unl-rpg/Unify/Hardware/Unify_1/Documentation/Igniters/MJG_Firewire_Initiator.png

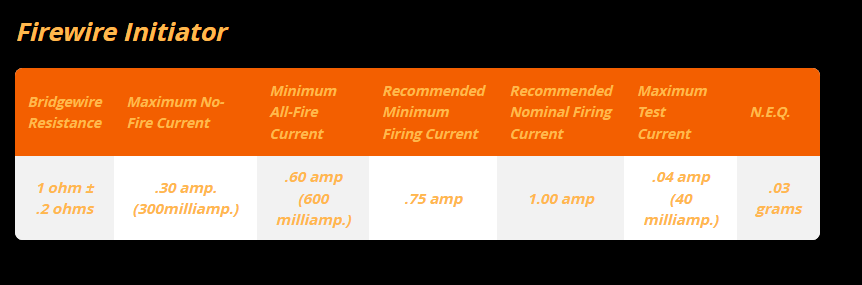
Hardware/Unify_1/Documentation/Igniters/MJG_Firewire_Initiator.png
