unl-rpg/Unify/Hardware/Unify_1/Documentation/Simulations/CapacitanceMultiplier5V.png

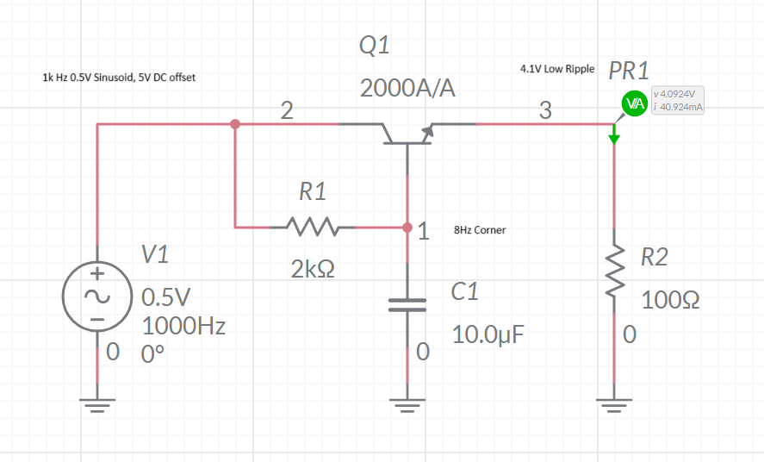
Hardware/Unify_1/Documentation/Simulations/CapacitanceMultiplier5V.png
