unl-rpg/Unify/Hardware/Unify_1/Documentation/Simulations/LinearIgniter.png

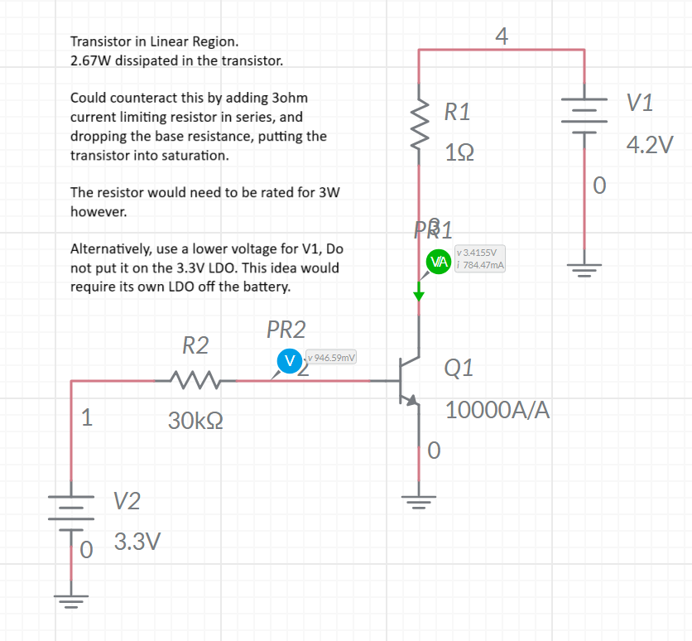
Hardware/Unify_1/Documentation/Simulations/LinearIgniter.png
