unl-rpg/Unify/Hardware/Unify_1/Documentation/Simulations/SaturationLevelShiftingInverter.png

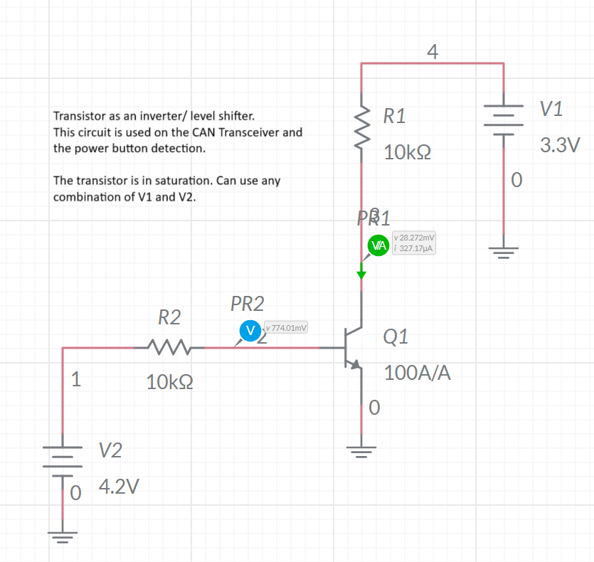
Hardware/Unify_1/Documentation/Simulations/SaturationLevelShiftingInverter.png
