unl-rpg/Unify/Hardware/Unify_1/Orders/JLCPCB_3-16-2025.pdf

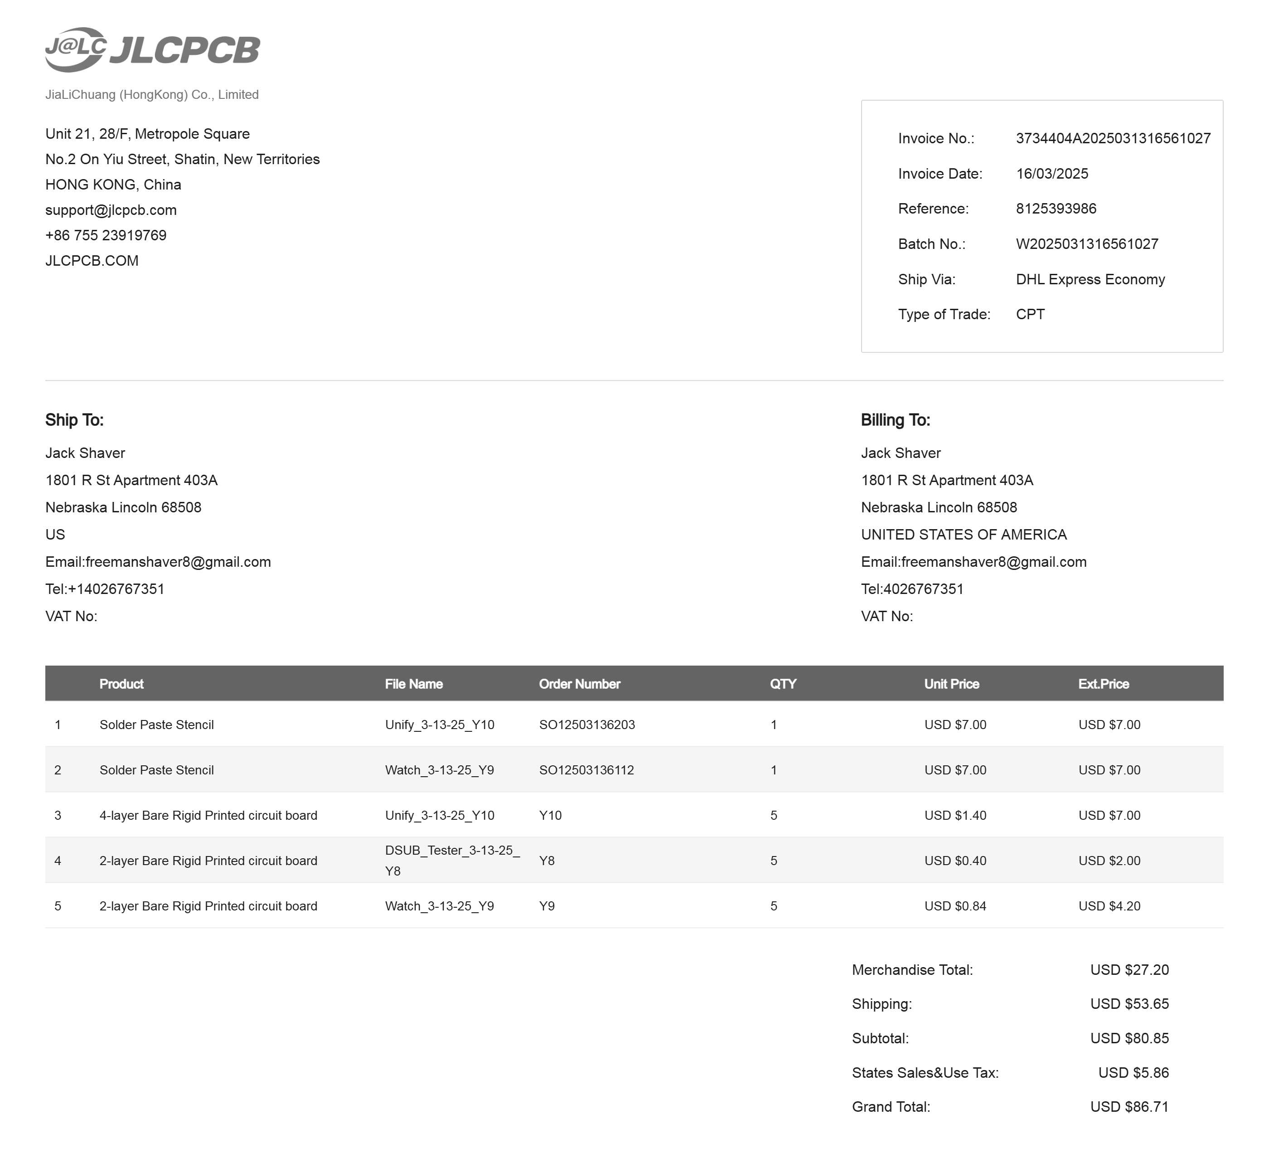
[picture p5: page 1]
