unl-rpg/Unify/Mechanical/Lid.stl

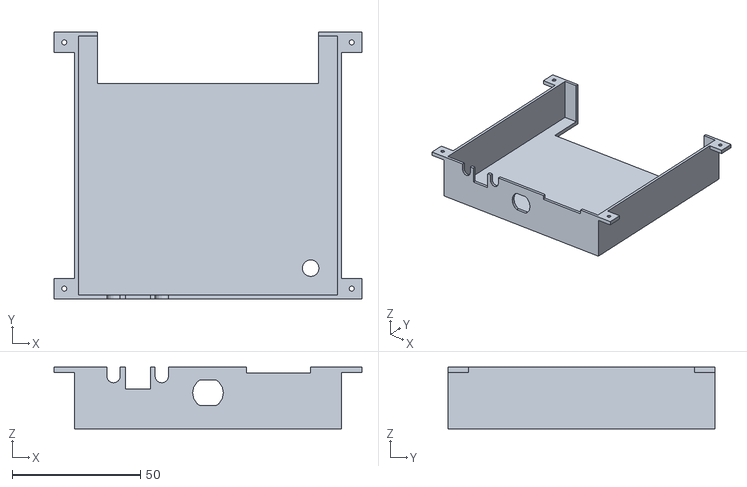
[picture p6: CAD file, 2025-05-09]
Mechanical/Lid.stl
120.0 x 104.0 x 24.0
