unl-rpg/Unify/Mechanical/Enclosure.stl

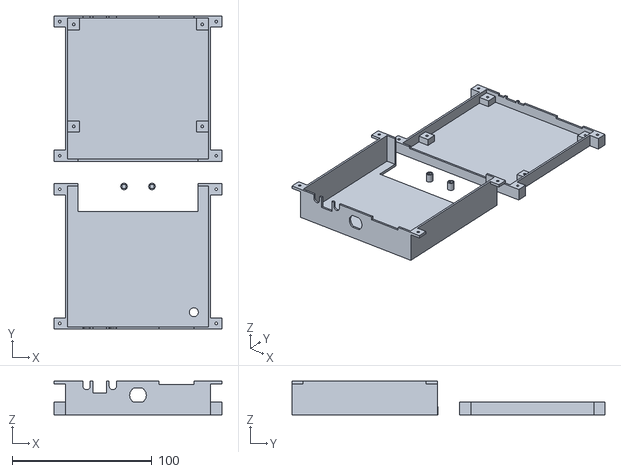
[picture p7: CAD file, 2025-05-09]
Mechanical/Enclosure.stl
120.0 x 224.0 x 24.0
