unl-rpg/Unify/Hardware/Unify_1/Orders/Amazon_3-20-2025.pdf

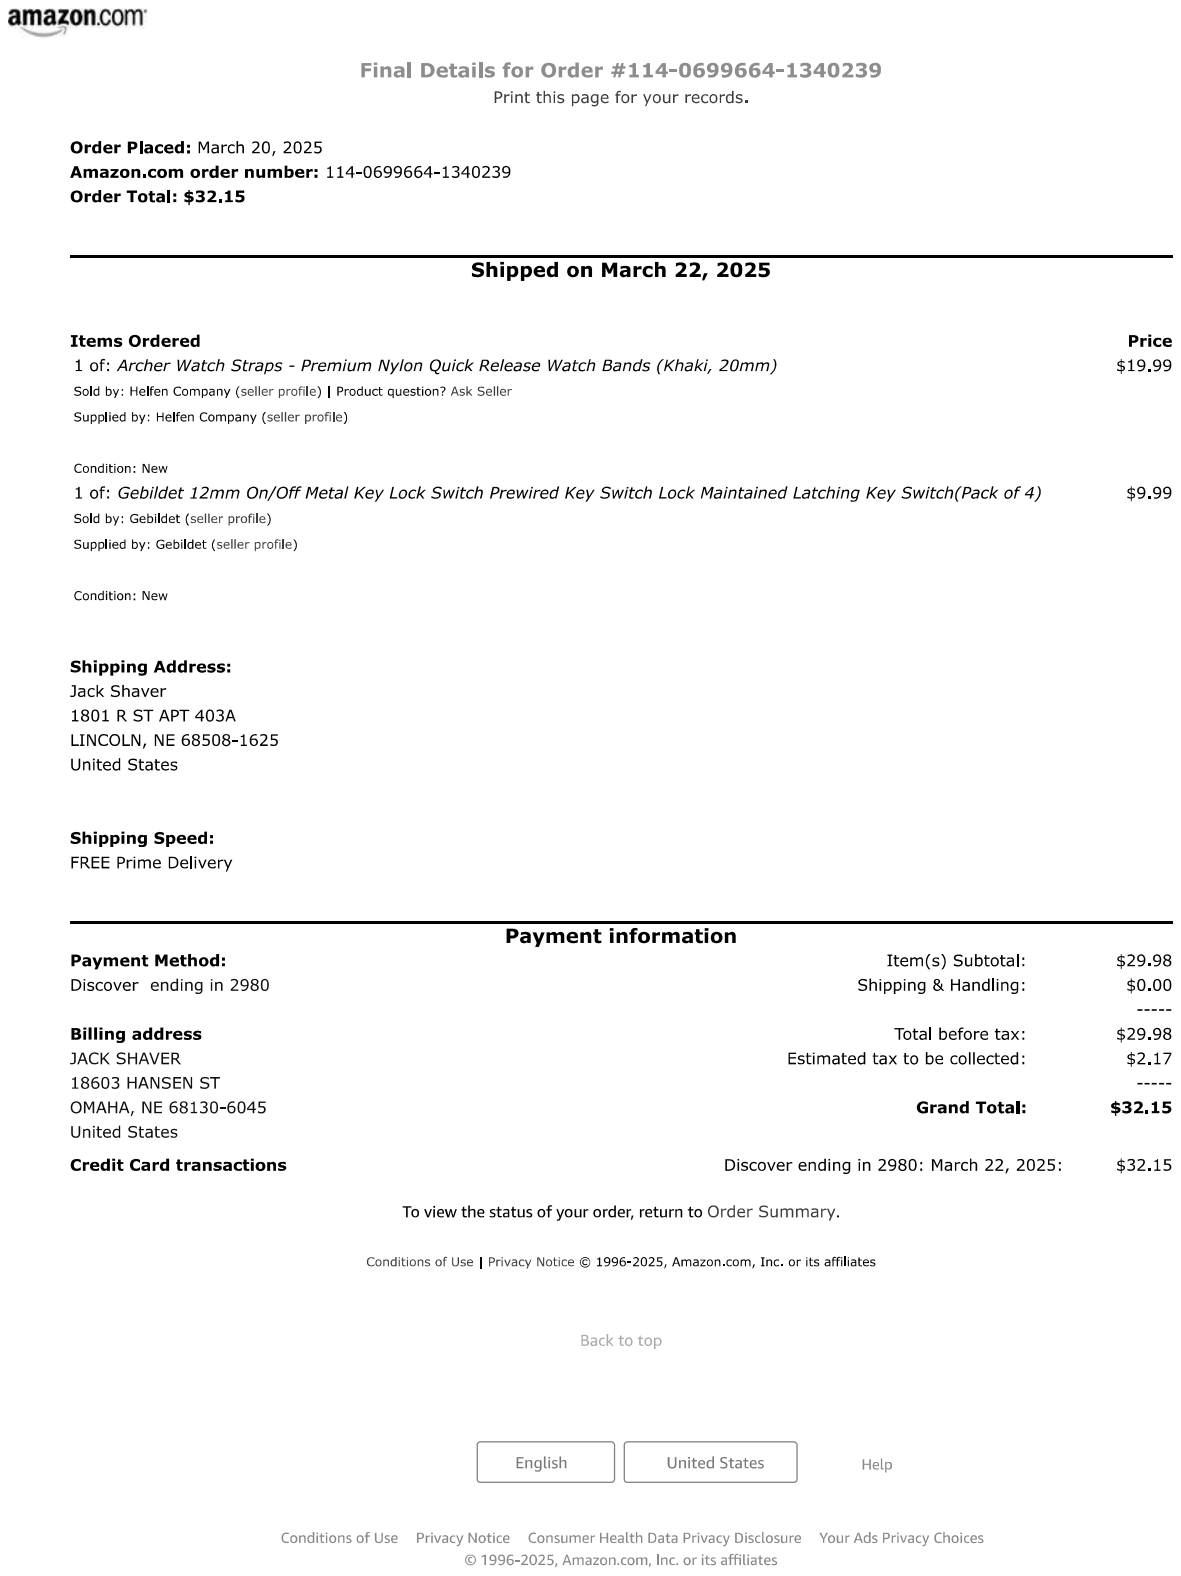
[picture p8: page 1]
