unl-rpg/Unify/Hardware/Unify_1/Orders/Digikey_3-21-2025.pdf

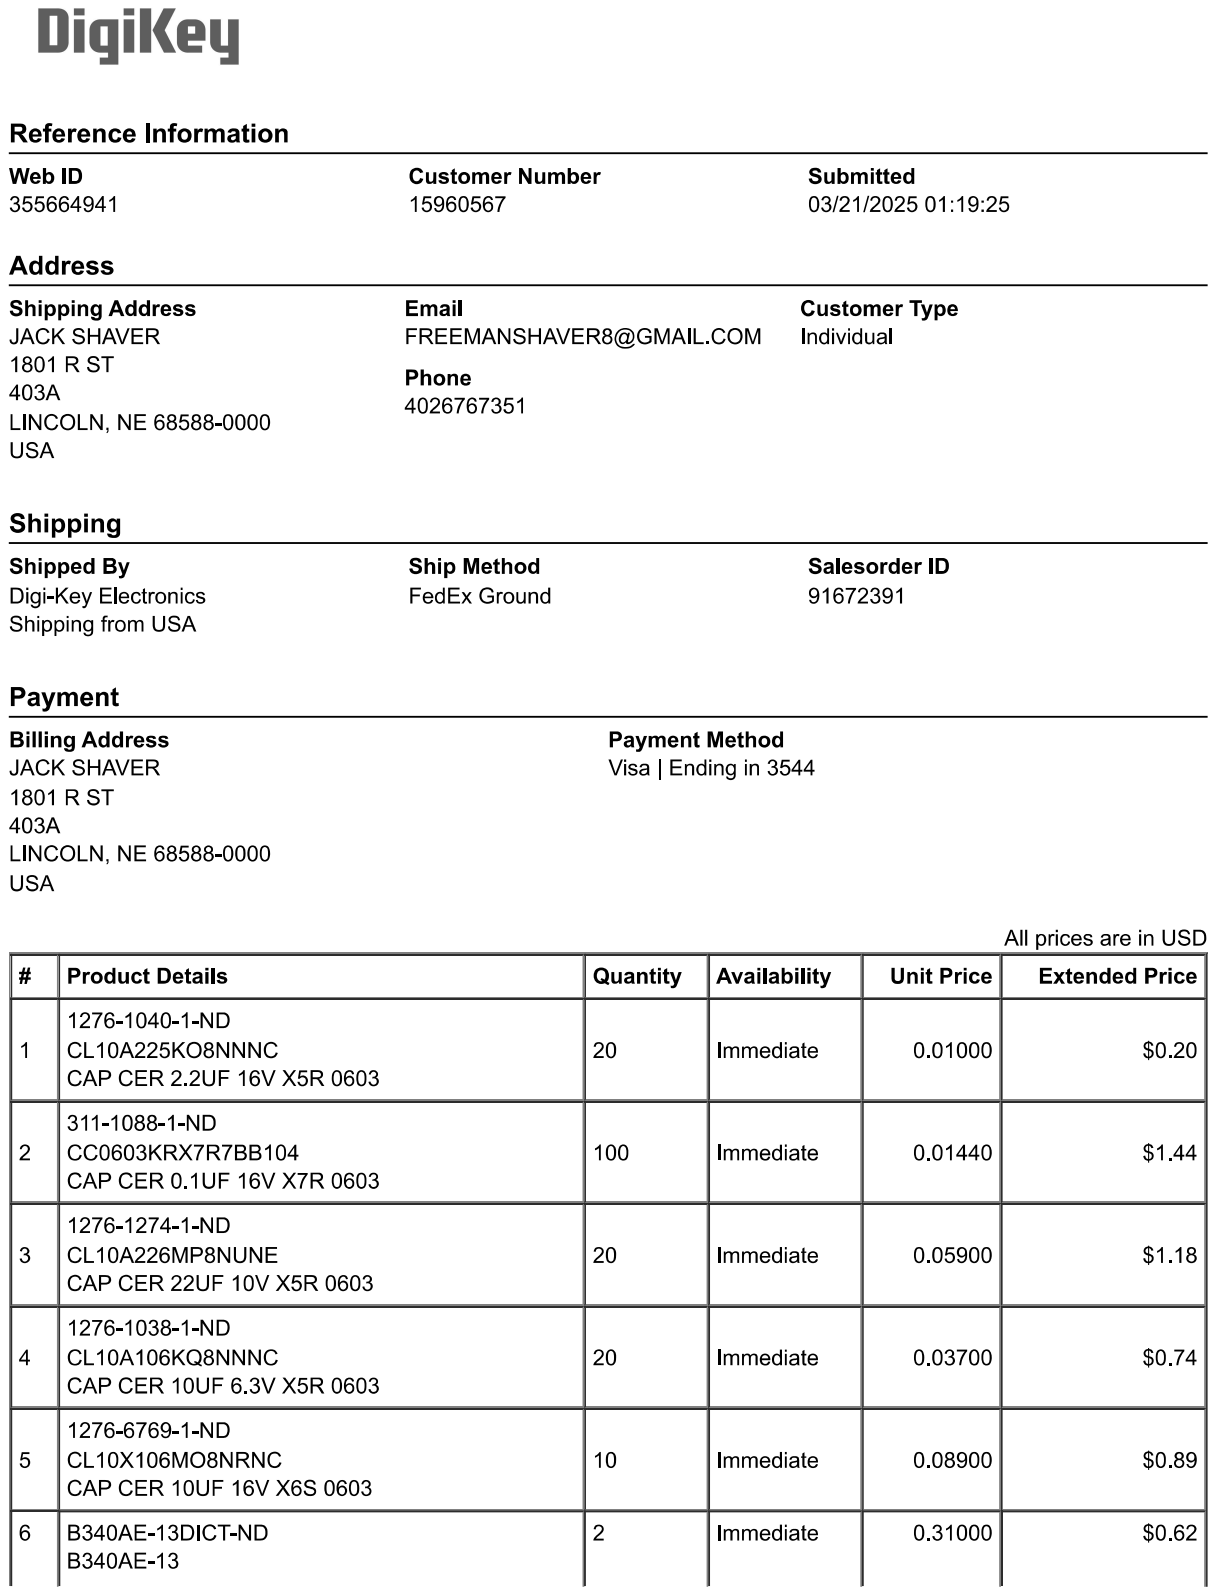
[picture p9: page 1]

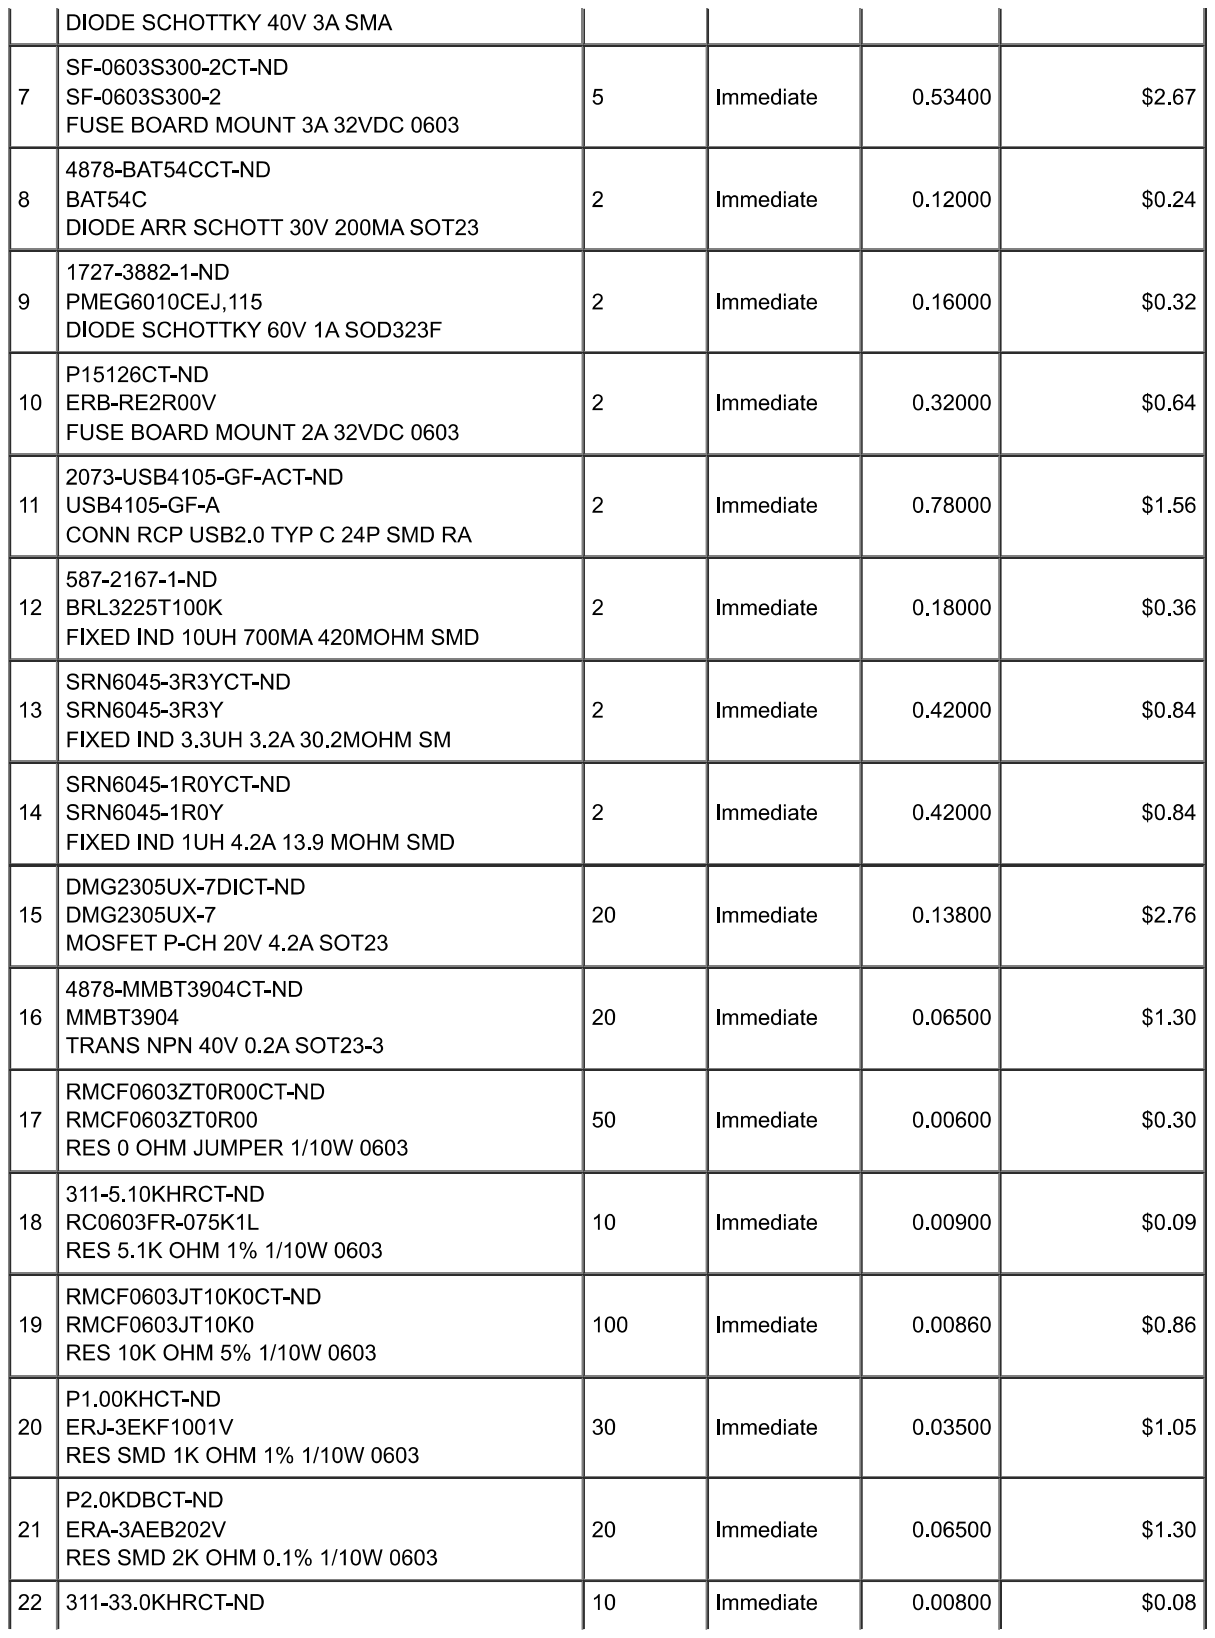
[picture p10: page 2]

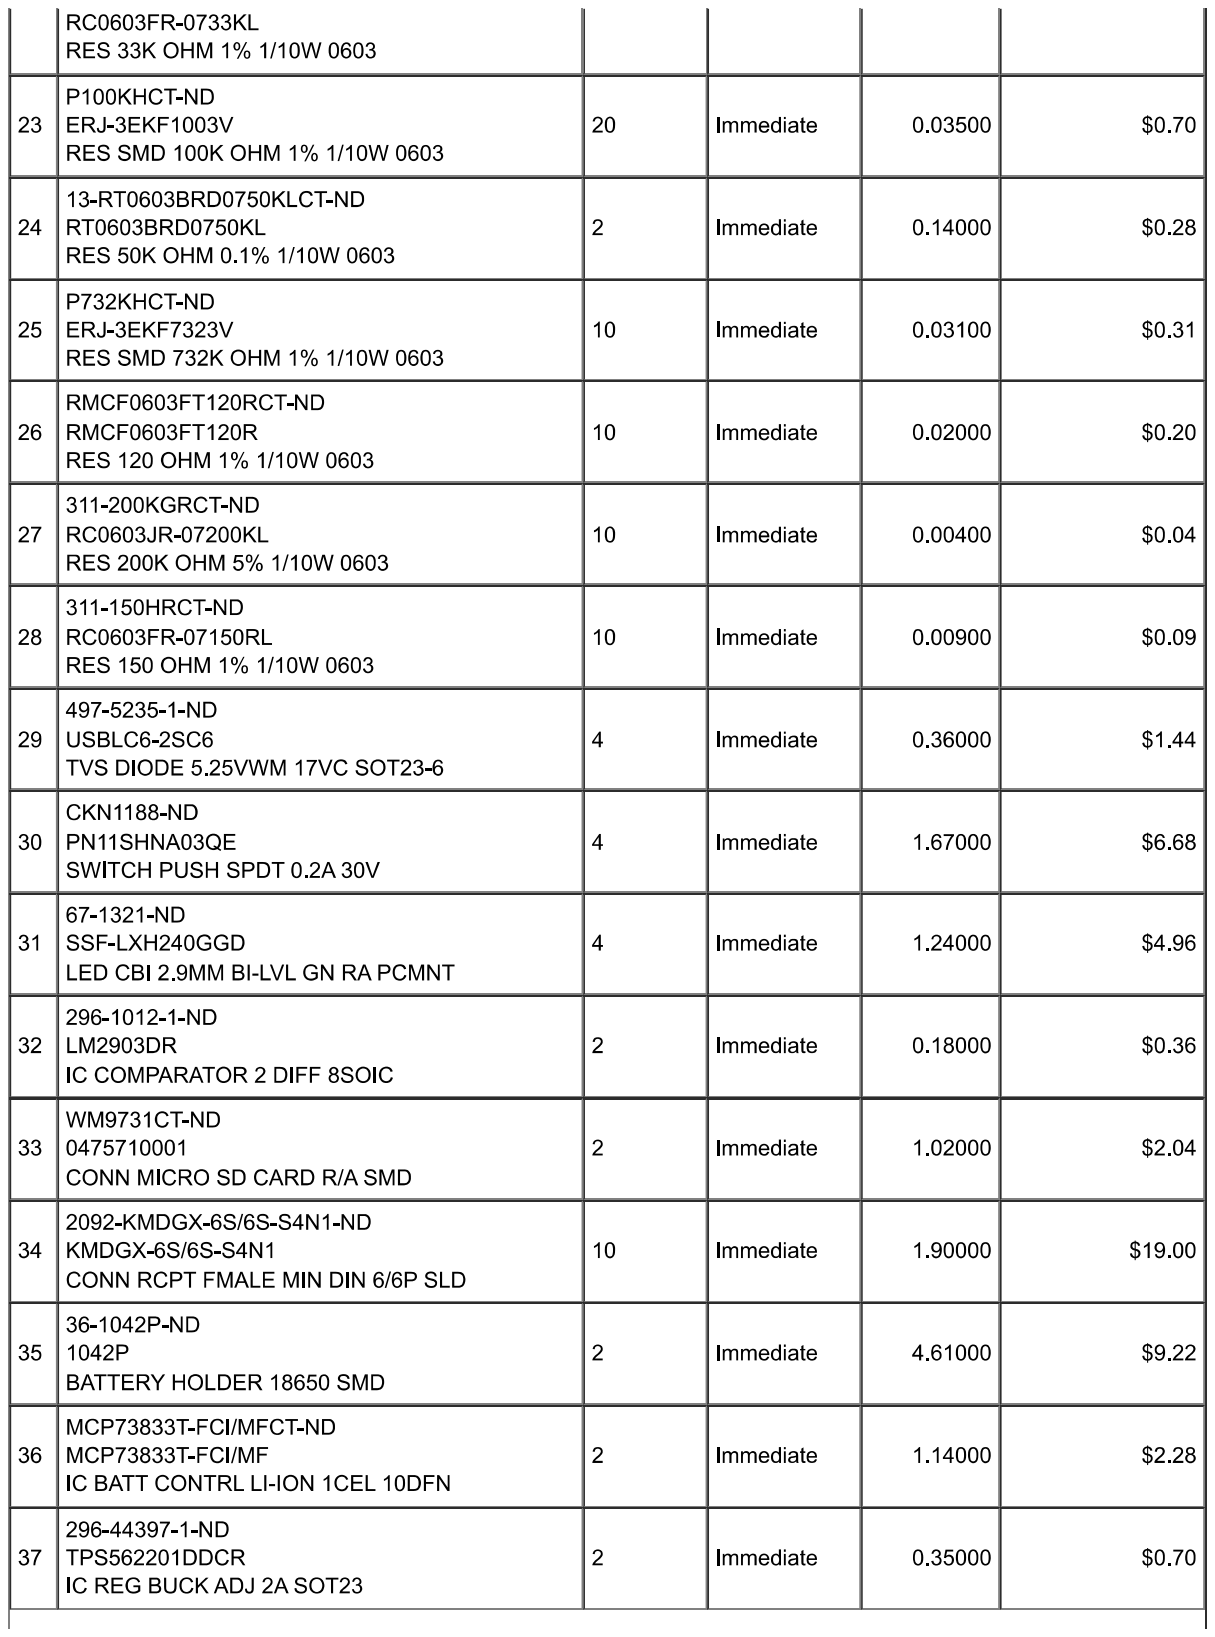
[picture p11: page 3]

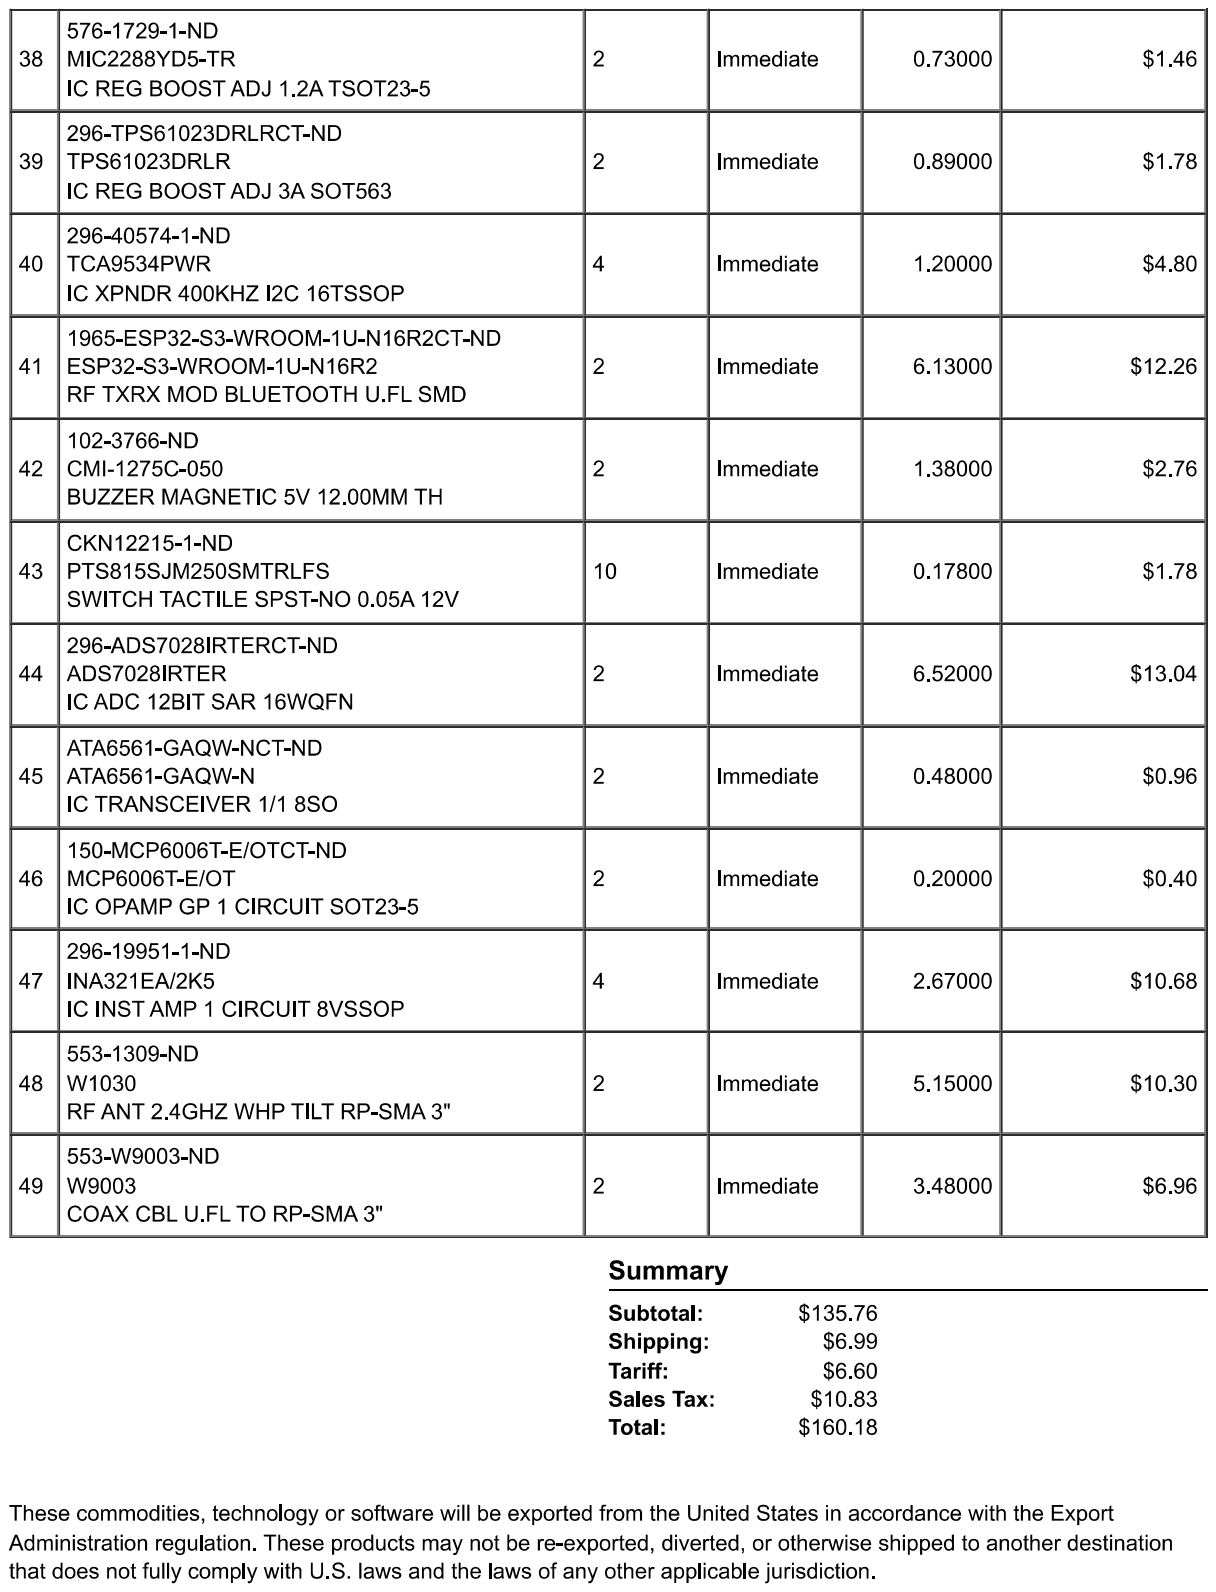
[picture p12: page 4]
