unl-rpg/Unify/Hardware/Unify_1/Orders/Digikey_4-4-2025.pdf

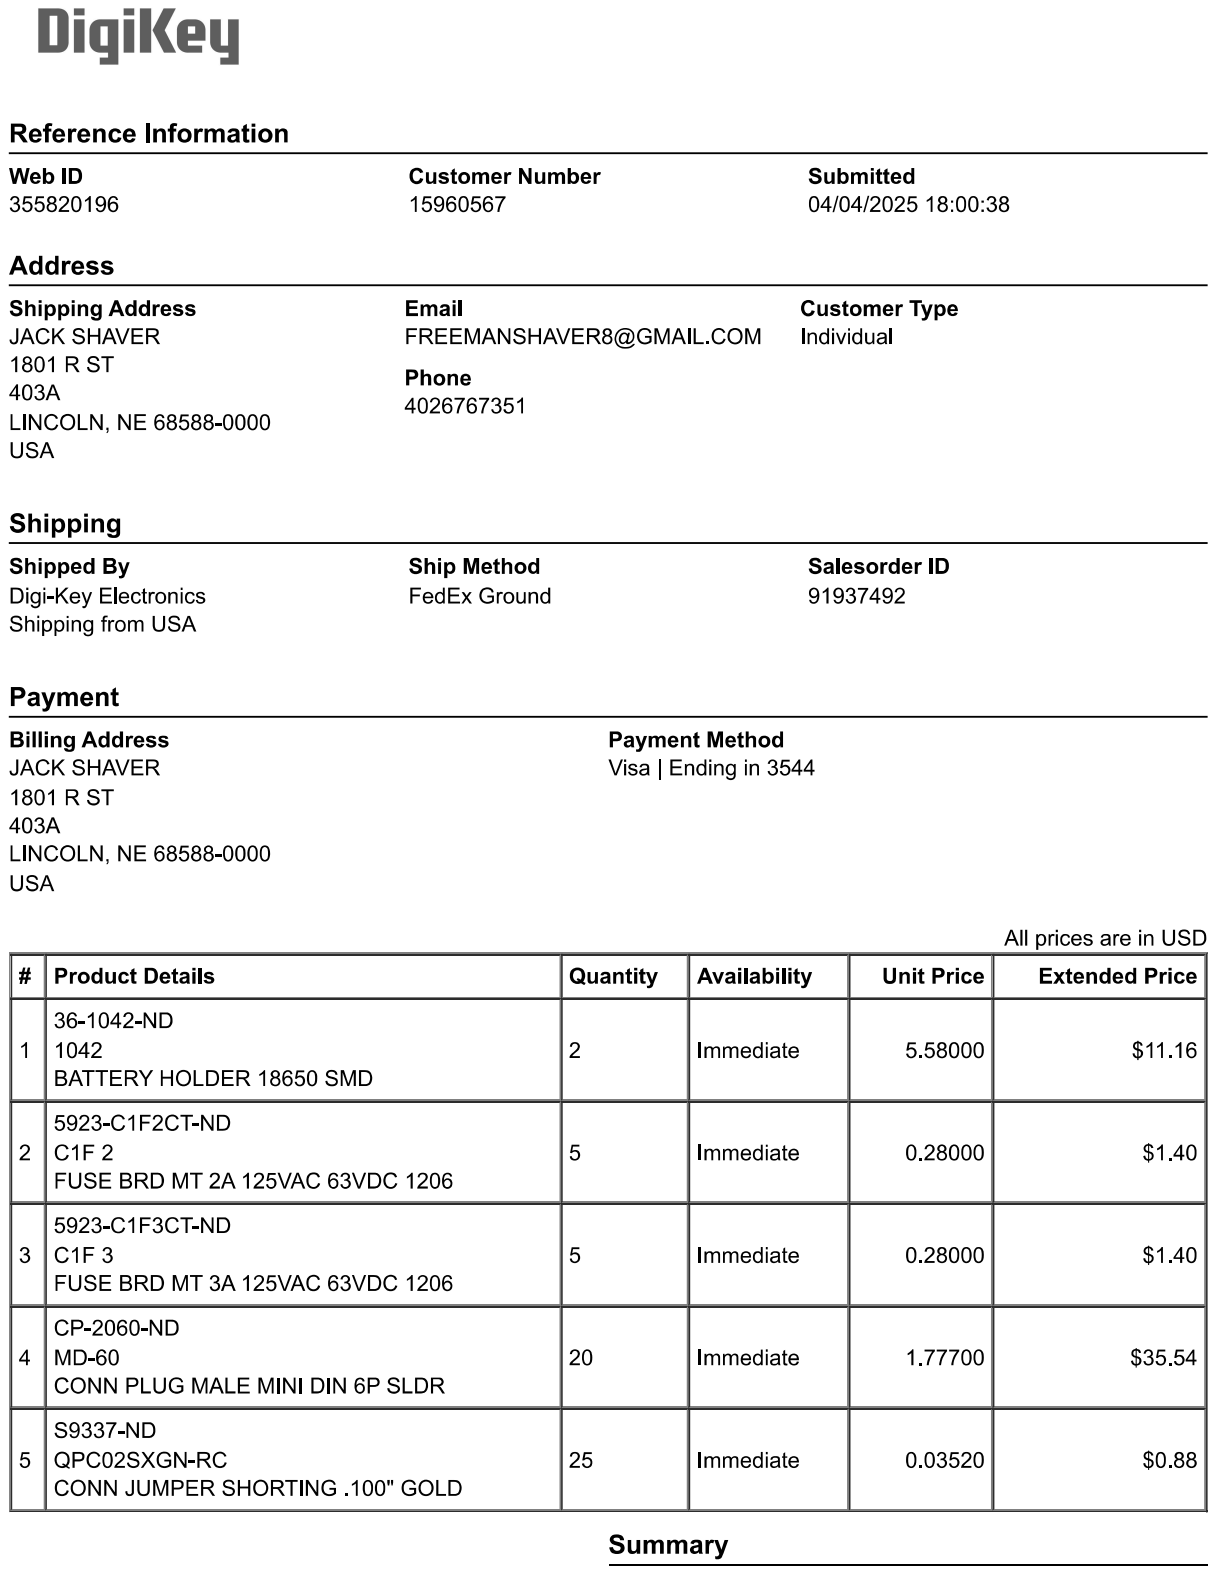
[picture p13: page 1]

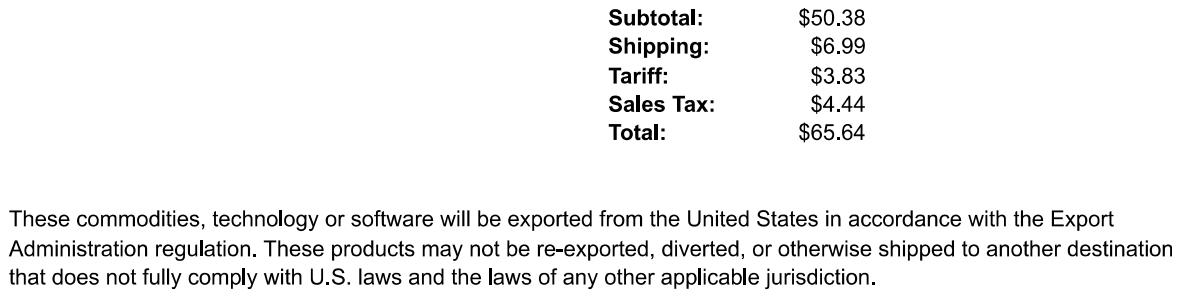
[picture p14: page 2]
