unl-rpg/Unify/Hardware/Unify_1/Unify_1.kicad_pcb

## KiCad design Hardware/Unify_1/Unify_1.kicad_pcb (2025-05-09)

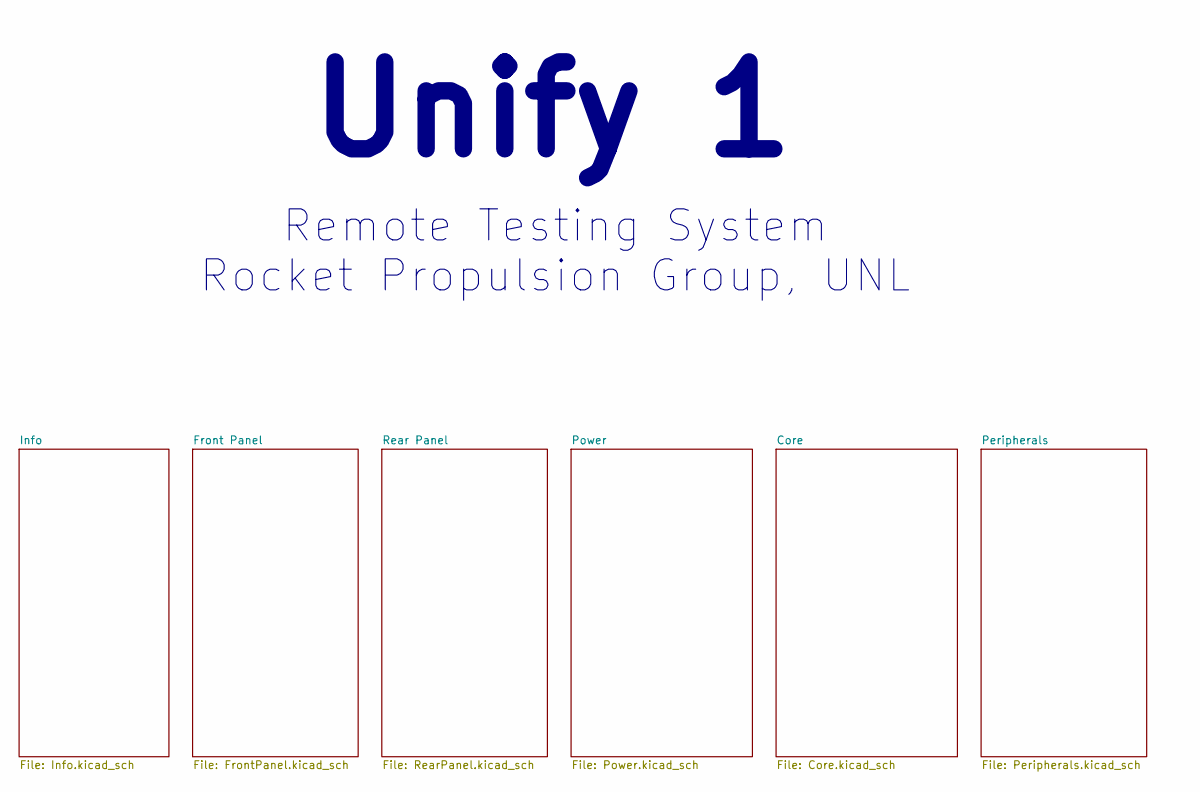
[picture p15: schematic Unify_1.kicad_sch, Unify]

Notes on the sheet:
Unify 1
Remote Testing System Rocket Propulsion Group, UNL

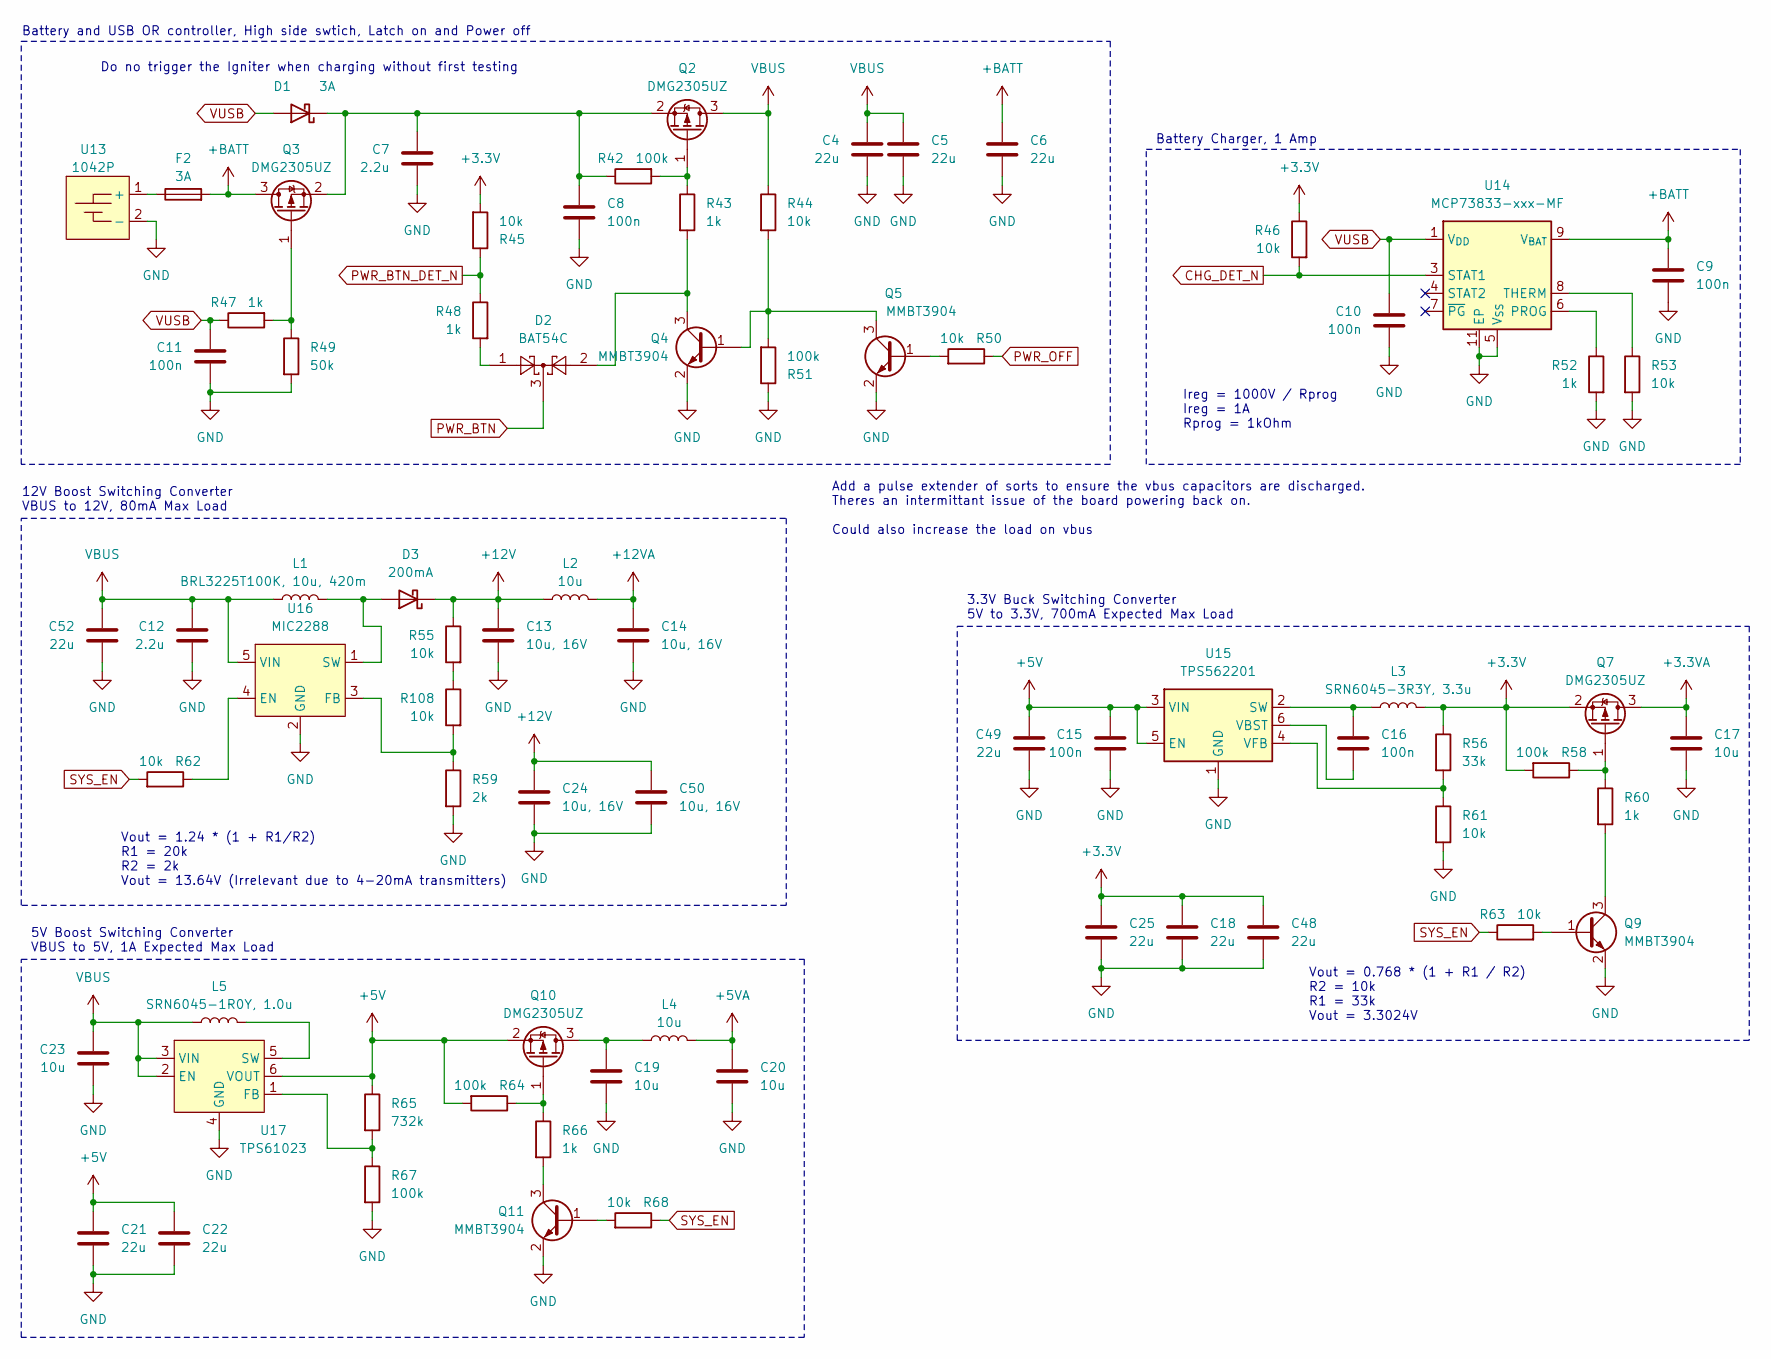
[picture p16: schematic Power.kicad_sch, Unify]

Parts:
C4, C5, C6, C18, C21, C22, C25, C48, C49, C52: 22u; C_0603_1608Metric
C7, C12: 2.2u; C_0603_1608Metric
C8, C9, C10, C11, C15, C16: 100n; C_0603_1608Metric
C13, C14, C24, C50: 10u, 16V; C_0603_1608Metric
C17, C19, C20, C23: 10u; C_0603_1608Metric
D1: 3A; D_SMA
D2: BAT54C; SOT-23
D3: 200mA; D_SOD-323
F2: 3A; Fuse_1206_3216Metric
L1: BRL3225T100K, 10u, 420m; L_1210_3225Metric
L2, L4: 10u; L_0805_2012Metric
L3: SRN6045-3R3Y, 3.3u; IND_BOURNS_SRN6045
L5: SRN6045-1R0Y, 1.0u; IND_BOURNS_SRN6045
Q2, Q3, Q7, Q10: DMG2305UZ; SOT-23
Q4, Q5, Q9, Q11: MMBT3904; SOT-23
R42, R51, R58, R64, R67: 100k; R_0603_1608Metric
R43, R47, R48, R52, R60, R66: 1k; R_0603_1608Metric
R44, R45, R46, R50, R53, R55, R61, R62, R63, R68, R108: 10k; R_0603_1608Metric
R49: 50k; R_0603_1608Metric
R56: 33k; R_0603_1608Metric
R59: 2k; R_0603_1608Metric
R65: 732k; R_0603_1608Metric
U13: 1042P; BAT_1042P
U14: MCP73833-xxx-MF; DFN-10-1EP_3x3mm_P0.5mm_EP1.58x2.35mm
U15: TPS562201; SOT-23-6
U16: MIC2288; TSOT-23-5
U17: TPS61023; SOT-563

Connections:
+5V: C15.1, C21.1, C22.1, C49.1, Q10.2 (S), R64.2, R65.1, U15.3 (VIN), U15.5 (EN), U17.6 (VOUT); also elsewhere on the board
+5VA: C20.1, L4.2; also elsewhere on the board
+12V: C13.1, C24.1, C50.1, D3.1 (K), L2.1, R55.1
+12VA: C14.1, L2.2; also elsewhere on the board
+BATT: C6.1, C9.1, F2.2, Q3.3 (D), U14.9 (V_{BAT}), U14.10 (V_{BAT}); also elsewhere on the board
CHG_DET_N: R46.2, U14.3 (STAT1); also elsewhere on the board
GND: C4.2, C5.2, C6.2, C7.2, C8.2, C9.2, C10.2, C11.2, C12.2, C13.2, C14.2, C15.2, C17.2, C18.2, C19.2, C20.2, C21.2, C22.2, C23.2, C24.2, C25.2, C48.2, C49.2, C50.2, C52.2, Q4.2 (E), Q5.2 (E), Q9.2 (E), Q11.2 (E), R49.2, R51.1, R52.2, R53.2, R59.2, R61.2, R67.2, U13.2 (-), U14.5 (V_{SS}), U14.11 (EP), U15.1 (GND), U16.2 (GND), U17.4 (GND); also elsewhere on the board
unnamed: C7.1, C8.1, D1.1 (K), Q2.2 (S), Q3.2 (S), R42.1
unnamed: D2.1, R48.2
unnamed: D3.2 (A), L1.2, U16.1 (SW)
unnamed: Q2.1 (G), R42.2, R43.1
unnamed: Q3.1 (G), R47.2, R49.1
unnamed: Q4.1 (B), Q5.3 (C), R44.2, R51.2
unnamed: D2.2, Q4.3 (C), R43.2
unnamed: Q5.1 (B), R50.2
unnamed: Q7.1 (G), R58.1, R60.1
unnamed: Q9.1 (B), R63.2
unnamed: Q9.3 (C), R60.2
unnamed: C19.1, L4.1, Q10.3 (D)
unnamed: Q10.1 (G), R64.1, R66.1
unnamed: Q11.1 (B), R68.2
unnamed: Q11.3 (C), R66.2
unnamed: R55.2, R108.1
unnamed: F2.1, U13.1 (+)
unnamed: R52.1, U14.6 (PROG)
unnamed: R53.1, U14.8 (THERM)
unnamed: C16.1, L3.1, U15.2 (SW)
unnamed: C16.2, U15.6 (VBST)
unnamed: R56.2, R61.1, U15.4 (VFB)
unnamed: R59.1, R108.2, U16.3 (FB)
unnamed: R65.2, R67.1, U17.1 (FB)
unnamed: L5.2, U17.5 (SW)
PWR_BTN: D2.3; also elsewhere on the board
PWR_BTN_DET_N: R45.1, R48.1; also elsewhere on the board
PWR_OFF: R50.1; also elsewhere on the board
VUSB: C10.1, C11.1, D1.2 (A), R47.1, U14.1 (V_{DD}), U14.2 (V_{DD}); also elsewhere on the board

Notes on the sheet:
Add a pulse extender of sorts to ensure the vbus capacitors are discharged. Theres an intermittant issue of the board powering back on. Could also increase the load on vbus
5V Boost Switching Converter VBUS to 5V, 1A Expected Max Load
Vout = 1.24 * (1 + R1/R2) R1 = 20k R2 = 2k Vout = 13.64V (Irrelevant due to 4-20mA transmitters)
3.3V Buck Switching Converter 5V to 3.3V, 700mA Expected Max Load
Battery and USB OR controller, High side swtich, Latch on and Power off
Battery Charger, 1 Amp
Ireg = 1000V / Rprog Ireg = 1A Rprog = 1kOhm
Do no trigger the Igniter when charging without first testing
Vout = 0.768 * (1 + R1 / R2) R2 = 10k R1 = 33k Vout = 3.3024V
12V Boost Switching Converter VBUS to 12V, 80mA Max Load

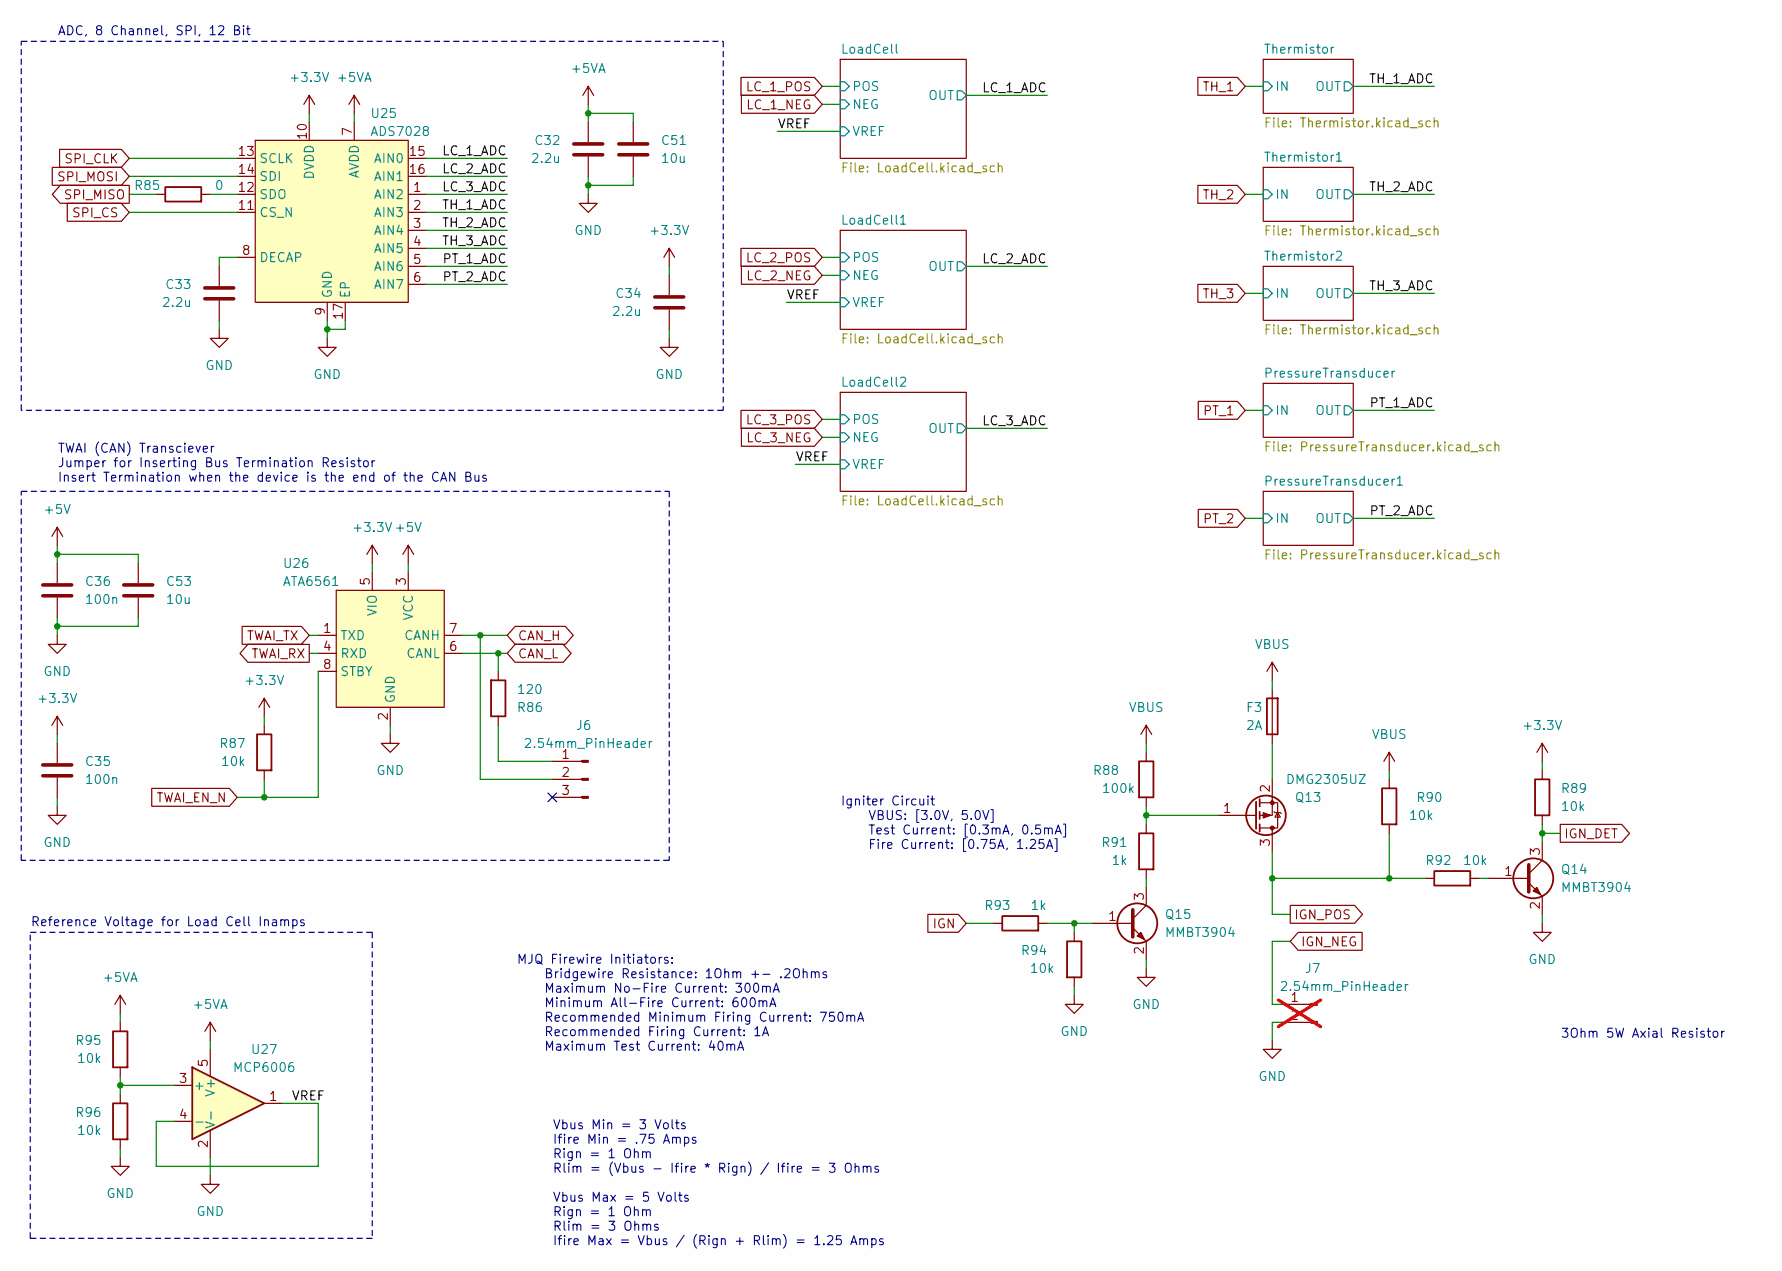
[picture p17: schematic Peripherals.kicad_sch, Unify]

Parts:
C32, C33, C34: 2.2u; C_0603_1608Metric
C35, C36: 100n; C_0603_1608Metric
C51, C53: 10u; C_0603_1608Metric
F3: 2A; Fuse_1206_3216Metric
J6: 2.54mm_PinHeader; PinHeader_1x03_P2.54mm_Vertical
J7: 2.54mm_PinHeader; PinHeader_1x02_P2.54mm_Vertical; not fitted
Q13: DMG2305UZ; SOT-23
Q14, Q15: MMBT3904; SOT-23
R85: 0; R_0603_1608Metric
R86: 120; R_0603_1608Metric
R87, R89, R90, R92, R94, R95, R96: 10k; R_0603_1608Metric
R88: 100k; R_0603_1608Metric
R91, R93: 1k; R_0603_1608Metric
U25: ADS7028; WQFN-16-1EP_3x3mm_P0.5mm_EP1.68x1.68mm
U26: ATA6561; SOIC-8_3.9x4.9mm_P1.27mm
U27: MCP6006; SOT-23-5

Connections:
+5V: C36.1, C53.1, U26.3 (VCC); also elsewhere on the board
+5VA: C32.1, C51.1, R95.1, U25.7 (AVDD), U27.5 (V+); also elsewhere on the board
/Peripherals/LC_1_ADC: U25.15 (AIN0); also elsewhere on the board
/Peripherals/LC_2_ADC: U25.16 (AIN1); also elsewhere on the board
/Peripherals/LC_3_ADC: U25.1 (AIN2); also elsewhere on the board
/Peripherals/VREF: U27.1, U27.4 (-); also elsewhere on the board
CAN_H: J6.2, U26.7 (CANH); also elsewhere on the board
CAN_L: R86.2, U26.6 (CANL); also elsewhere on the board
GND: C32.2, C33.2, C34.2, C35.2, C36.2, C51.2, C53.2, J7.2, Q14.2 (E), Q15.2 (E), R94.2, R96.2, U25.9 (GND), U25.17 (EP), U26.2 (GND), U27.2 (V-); also elsewhere on the board
IGN: R93.1; also elsewhere on the board
IGN_DET: Q14.3 (C), R89.2; also elsewhere on the board
IGN_NEG: J7.1; also elsewhere on the board
IGN_POS: Q13.3 (D), R90.2, R92.1; also elsewhere on the board
unnamed: J6.1, R86.1
unnamed: Q13.1 (G), R88.2, R91.1
unnamed: F3.1, Q13.2 (S)
unnamed: Q14.1 (B), R92.2
unnamed: Q15.1 (B), R93.2, R94.1
unnamed: Q15.3 (C), R91.2
unnamed: C33.1, U25.8 (DECAP)
unnamed: R85.2, U25.12 (SDO)
unnamed: R95.2, R96.1, U27.3 (+)
PT_1: U25.5 (AIN6); also elsewhere on the board
PT_2: U25.6 (AIN7); also elsewhere on the board
SPI_MISO: R85.1; also elsewhere on the board
SPI_MOSI: U25.14 (SDI); also elsewhere on the board
TH_1: U25.2 (AIN3); also elsewhere on the board
TH_2: U25.3 (AIN4); also elsewhere on the board
TH_3: U25.4 (AIN5); also elsewhere on the board
TWAI_EN_N: R87.2, U26.8 (STBY); also elsewhere on the board
TWAI_RX: U26.4 (RXD); also elsewhere on the board
TWAI_TX: U26.1 (TXD); also elsewhere on the board

Notes on the sheet:
Reference Voltage for Load Cell Inamps
MJQ Firewire Initiators: Bridgewire Resistance: 1Ohm +- .2Ohms Maximum No-Fire Current: 300mA Minimum All-Fire Current: 600mA Recommended Minimum Firing Current: 750mA Recommended Firing Current: 1A Maximum Test Current: 40mA
TWAI (CAN) Transciever Jumper for Inserting Bus Termination Resistor Insert Termination when the device is the end of the CAN Bus
ADC, 8 Channel, SPI, 12 Bit
Vbus Min = 3 Volts Ifire Min = .75 Amps Rign = 1 Ohm Rlim = (Vbus - Ifire * Rign) / Ifire = 3 Ohms Vbus Max = 5 Volts Rign = 1 Ohm Rlim = 3 Ohms Ifire Max = Vbus / (Rign + Rlim) = 1.25 Amps
3Ohm 5W Axial Resistor
Igniter Circuit VBUS: [3.0V, 5.0V] Test Current: [0.3mA, 0.5mA] Fire Current: [0.75A, 1.25A]

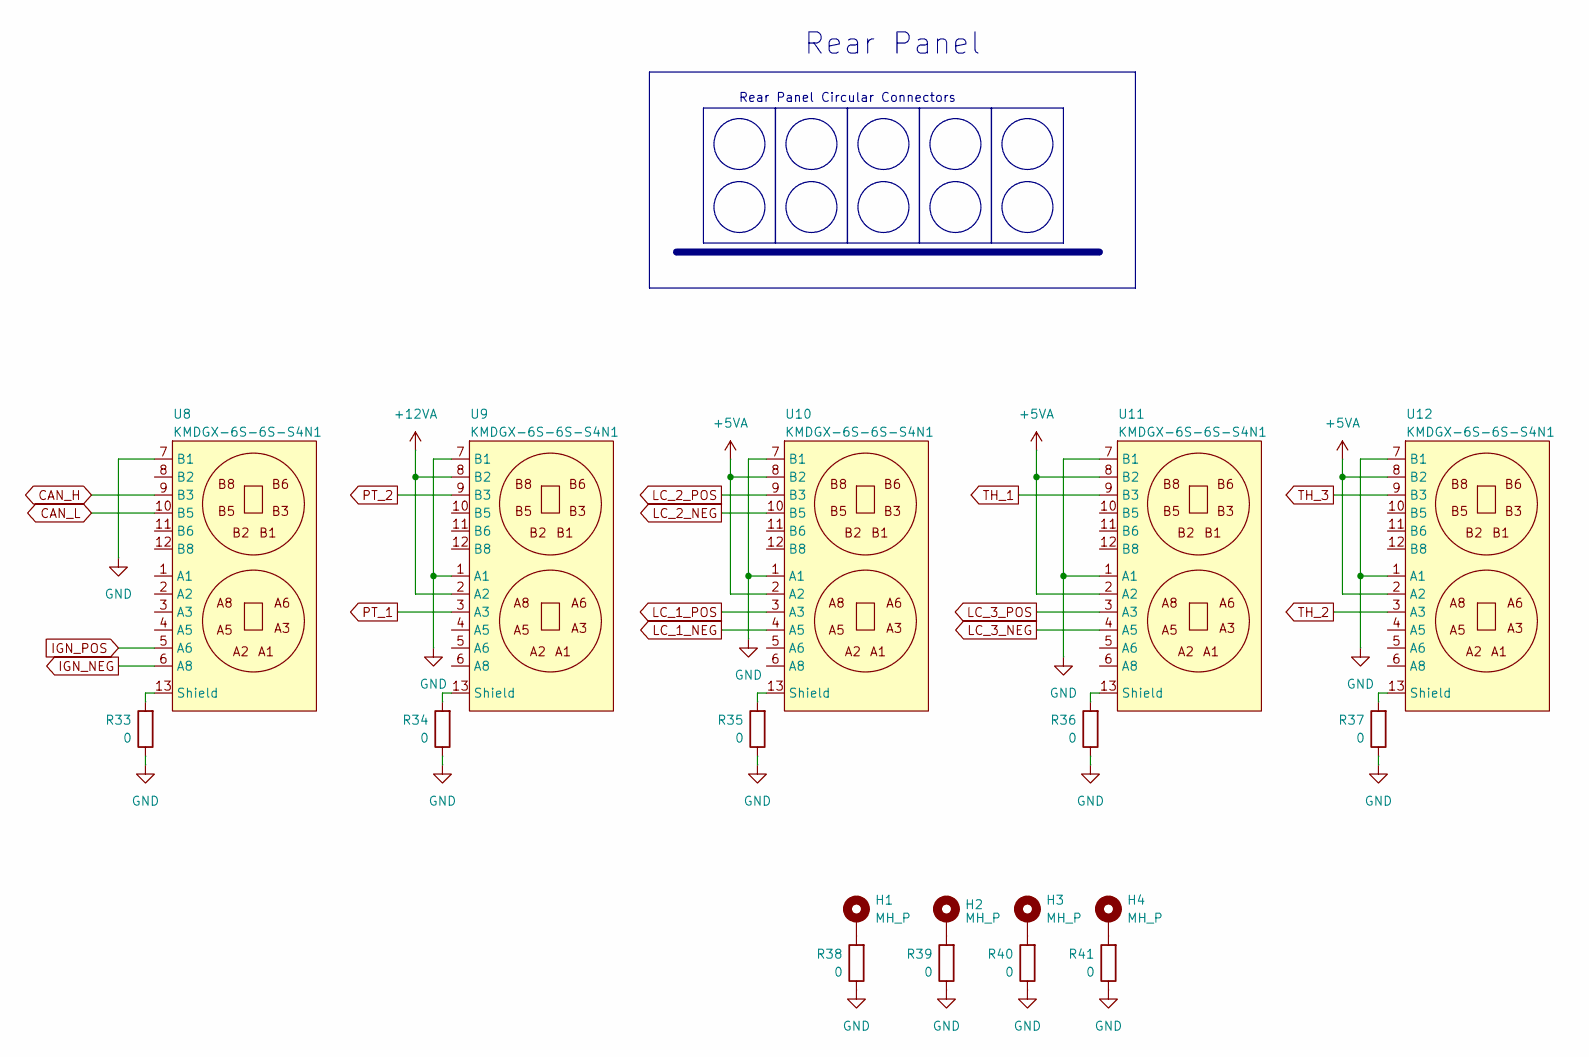
[picture p18: schematic RearPanel.kicad_sch, Unify]

Parts:
H1, H2, H3, H4: MH_P; MountingHole_2.7mm_M2.5_Pad
R33, R34, R35, R36, R37, R38, R39, R40, R41: 0; R_0603_1608Metric
U8, U9, U10, U11, U12: KMDGX-6S-6S-S4N1

Connections:
+5VA: U10.2 (A2), U10.8 (B2), U11.2 (A2), U11.8 (B2), U12.2 (A2), U12.8 (B2); also elsewhere on the board
+12VA: U9.2 (A2), U9.8 (B2); also elsewhere on the board
CAN_H: U8.9 (B3); also elsewhere on the board
CAN_L: U8.10 (B5); also elsewhere on the board
GND: R33.1, R34.1, R35.1, R36.1, R37.1, R38.1, R39.1, R40.1, R41.1, U8.7 (B1), U9.1 (A1), U9.7 (B1), U10.1 (A1), U10.7 (B1), U11.1 (A1), U11.7 (B1), U12.1 (A1), U12.7 (B1); also elsewhere on the board
IGN_NEG: U8.6 (A8); also elsewhere on the board
IGN_POS: U8.5 (A6); also elsewhere on the board
LC_1_NEG: U10.4 (A5); also elsewhere on the board
LC_1_POS: U10.3 (A3); also elsewhere on the board
LC_2_NEG: U10.10 (B5); also elsewhere on the board
LC_2_POS: U10.9 (B3); also elsewhere on the board
LC_3_NEG: U11.4 (A5); also elsewhere on the board
LC_3_POS: U11.3 (A3); also elsewhere on the board
unnamed: H1.1, R38.2
unnamed: H2.1, R39.2
unnamed: H3.1, R40.2
unnamed: H4.1, R41.2
unnamed: R33.2, U8.13 (Shield)
unnamed: R34.2, U9.13 (Shield)
unnamed: R35.2, U10.13 (Shield)
unnamed: R36.2, U11.13 (Shield)
unnamed: R37.2, U12.13 (Shield)
PT_1: U9.3 (A3); also elsewhere on the board
PT_2: U9.9 (B3); also elsewhere on the board
TH_1: U11.9 (B3); also elsewhere on the board
TH_2: U12.3 (A3); also elsewhere on the board
TH_3: U12.9 (B3); also elsewhere on the board

Notes on the sheet:
Rear Panel Circular Connectors
Rear Panel

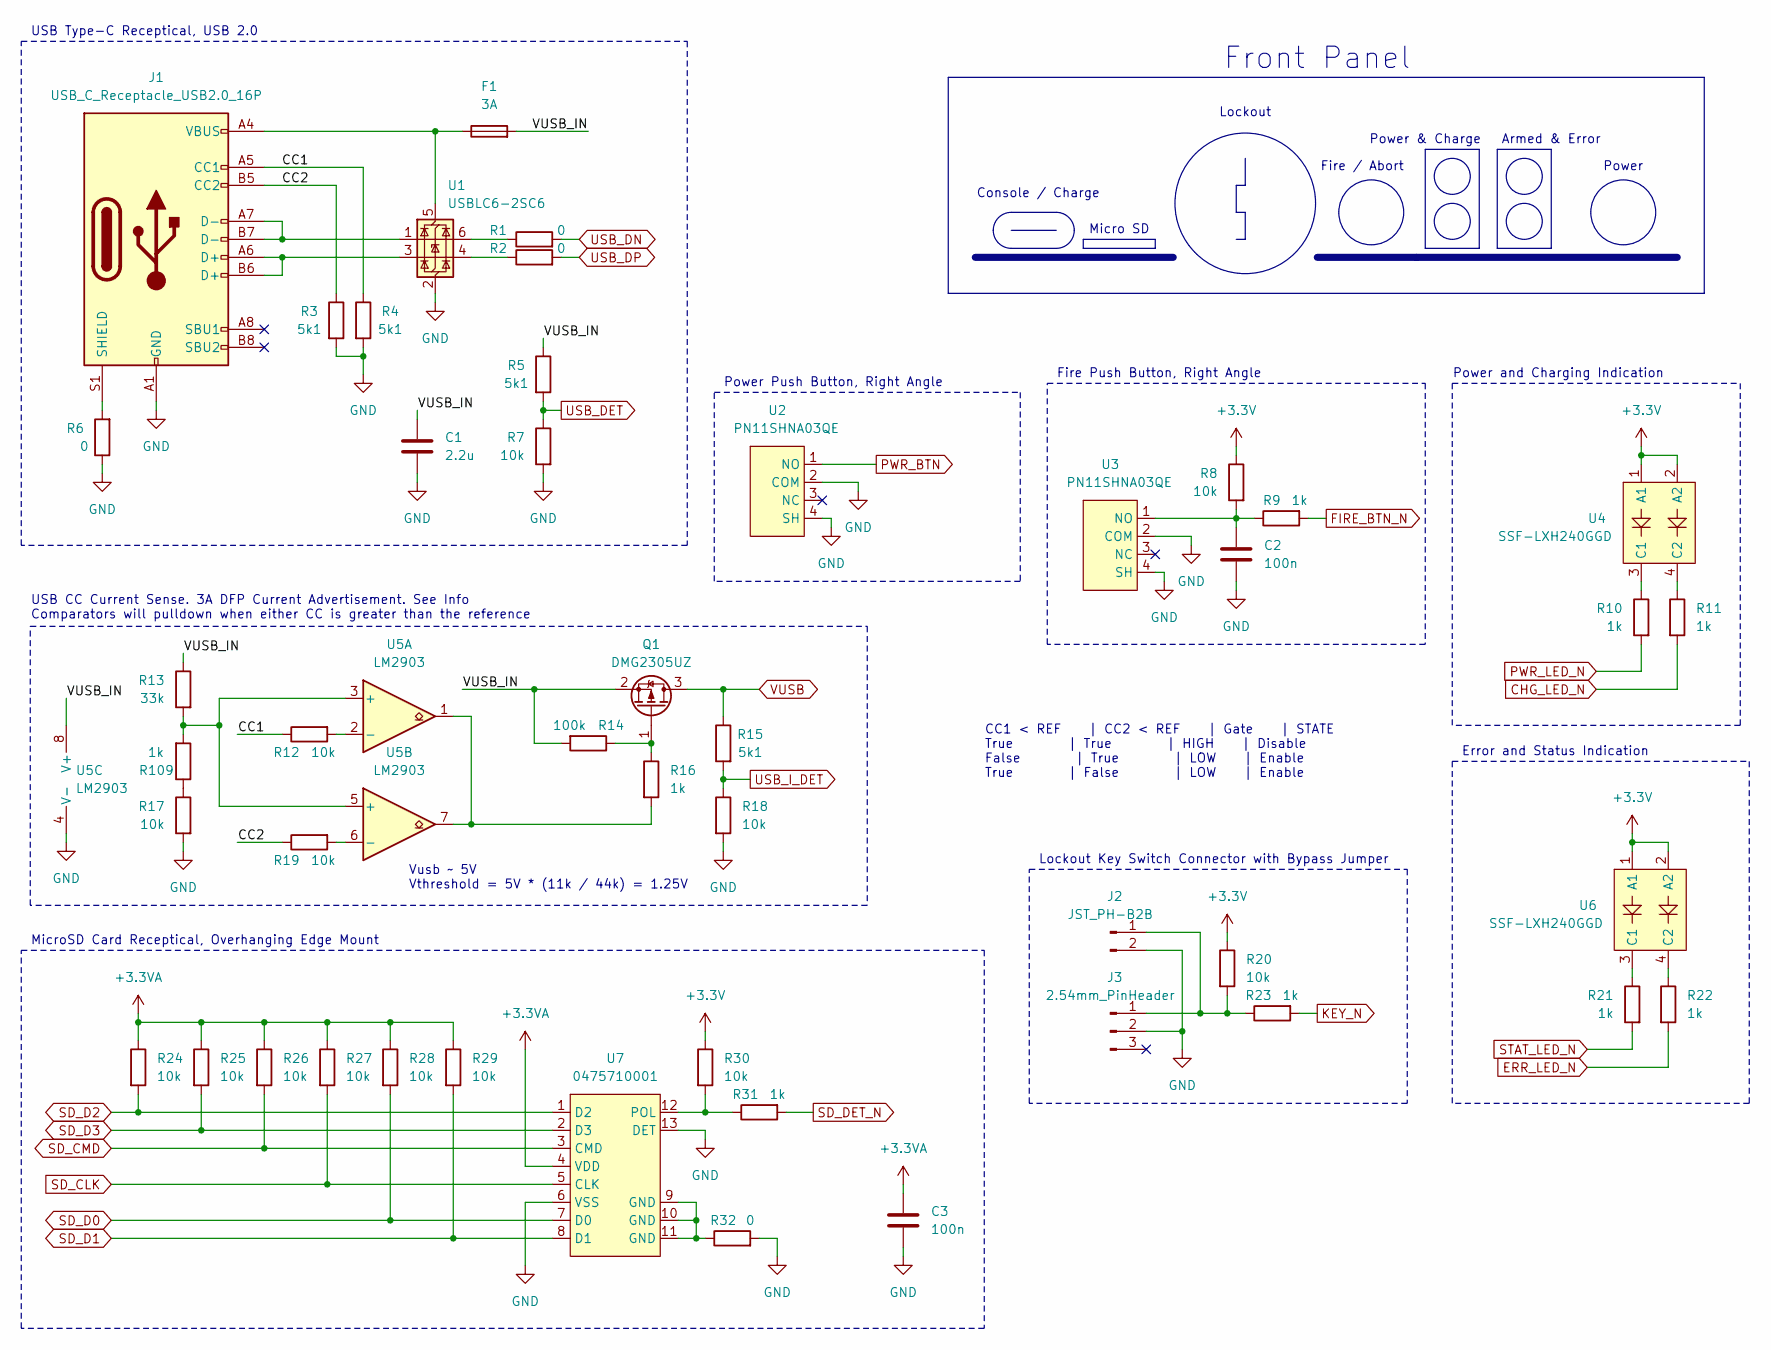
[picture p19: schematic FrontPanel.kicad_sch, Unify]

Parts:
C1: 2.2u; C_0603_1608Metric
C2, C3: 100n; C_0603_1608Metric
F1: 3A; Fuse_0603_1608Metric
J1: USB_C_Receptacle_USB2.0_16P; USB_C_Receptacle_GCT_USB4105-xx-A_16P_TopMnt_Horizontal
J2: JST_PH-B2B; JST_PH_B2B-PH-K_1x02_P2.00mm_Vertical
J3: 2.54mm_PinHeader; PinHeader_1x03_P2.54mm_Vertical
Q1: DMG2305UZ; SOT-23
R1, R2, R6, R32: 0; R_0603_1608Metric
R3, R4, R5, R15: 5k1; R_0603_1608Metric
R7, R8, R12, R17, R18, R19, R20, R24, R25, R26, R27, R28, R29, R30: 10k; R_0603_1608Metric
R9, R10, R11, R16, R21, R22, R23, R31, R109: 1k; R_0603_1608Metric
R13: 33k; R_0603_1608Metric
R14: 100k; R_0603_1608Metric
U1: USBLC6-2SC6; SOT-23-6
U2, U3: PN11SHNA03QE
U4, U6: SSF-LXH240GGD
U5: LM2903; SOIC-8_3.9x4.9mm_P1.27mm
U7: 0475710001; 47571-0001_MOL

Connections:
/Front Panel/CC1: J1.A5 (CC1), R4.1, R12.1
/Front Panel/CC2: J1.B5 (CC2), R3.1, R19.1
/Front Panel/VUSB_IN: C1.1, F1.2, Q1.2 (S), R5.1, R13.1, R14.2, U5.8 (V+)
CHG_LED_N: R11.2; also elsewhere on the board
ERR_LED_N: R22.2; also elsewhere on the board
FIRE_BTN_N: R9.2; also elsewhere on the board
GND: C1.2, C2.2, C3.2, J1.A1 (GND), J1.A12 (GND), J1.B1 (GND), J1.B12 (GND), J2.2, J3.2, R3.2, R4.2, R6.1, R7.2, R17.2, R18.2, R32.2, U1.2 (GND), U2.2 (COM), U2.4 (SH), U3.2 (COM), U3.4 (SH), U5.4 (V-), U7.6 (VSS), U7.13 (DET); also elsewhere on the board
KEY_N: R23.2; also elsewhere on the board
unnamed: J1.A6 (D+), J1.B6 (D+), U1.3 (I/O2)
unnamed: J1.A7 (D-), J1.B7 (D-), U1.1 (I/O1)
unnamed: J1.S1 (SHIELD), R6.2
unnamed: J2.1, J3.1, R20.2, R23.1
unnamed: Q1.1 (G), R14.1, R16.1
unnamed: R1.1, U1.6 (I/O1)
unnamed: R2.1, U1.4 (I/O2)
unnamed: R16.2, U5.1, U5.7
unnamed: R32.1, U7.9 (GND), U7.10 (GND), U7.11 (GND)
unnamed: R17.1, R109.1
unnamed: F1.1, J1.A4 (VBUS), J1.A9 (VBUS), J1.B4 (VBUS), J1.B9 (VBUS), U1.5 (VBUS)
unnamed: C2.1, R8.2, R9.1, U3.1 (NO)
unnamed: R10.1, U4.3 (C1)
unnamed: R11.1, U4.4 (C2)
unnamed: R13.2, R109.2, U5.3 (+), U5.5 (+)
unnamed: R12.2, U5.2 (-)
unnamed: R19.2, U5.6 (-)
unnamed: R21.1, U6.3 (C1)
unnamed: R22.1, U6.4 (C2)
unnamed: R30.2, R31.1, U7.12 (POL)
PWR_BTN: U2.1 (NO); also elsewhere on the board
PWR_LED_N: R10.2; also elsewhere on the board
SD_CLK: R27.2, U7.5 (CLK); also elsewhere on the board
SD_CMD: R26.2, U7.3 (CMD); also elsewhere on the board
SD_D0: R28.2, U7.7 (D0); also elsewhere on the board
SD_D1: R29.2, U7.8 (D1); also elsewhere on the board
SD_D2: R24.2, U7.1 (D2); also elsewhere on the board
SD_D3: R25.2, U7.2 (D3); also elsewhere on the board
SD_DET_N: R31.2; also elsewhere on the board
STAT_LED_N: R21.2; also elsewhere on the board
USB_DET: R5.2, R7.1; also elsewhere on the board
USB_DN: R1.2; also elsewhere on the board
USB_DP: R2.2; also elsewhere on the board
USB_I_DET: R15.2, R18.1; also elsewhere on the board
VUSB: Q1.3 (D), R15.1; also elsewhere on the board

Notes on the sheet:
Fire Push Button, Right Angle
Vusb ~ 5V Vthreshold = 5V * (11k / 44k) = 1.25V
MicroSD Card Receptical, Overhanging Edge Mount
USB Type-C Receptical, USB 2.0
Console / Charge
USB CC Current Sense. 3A DFP Current Advertisement. See Info Comparators will pulldown when either CC is greater than the reference
Micro SD
Error and Status Indication
Power
Armed & Error
Front Panel
CC1 < REF | CC2 < REF | Gate | STATE True | True | HIGH | Disable False | True | LOW | Enable True | False | LOW | Enable
Lockout Key Switch Connector with Bypass Jumper
Power and Charging Indication
Power Push Button, Right Angle
Lockout
Power & Charge
Fire / Abort

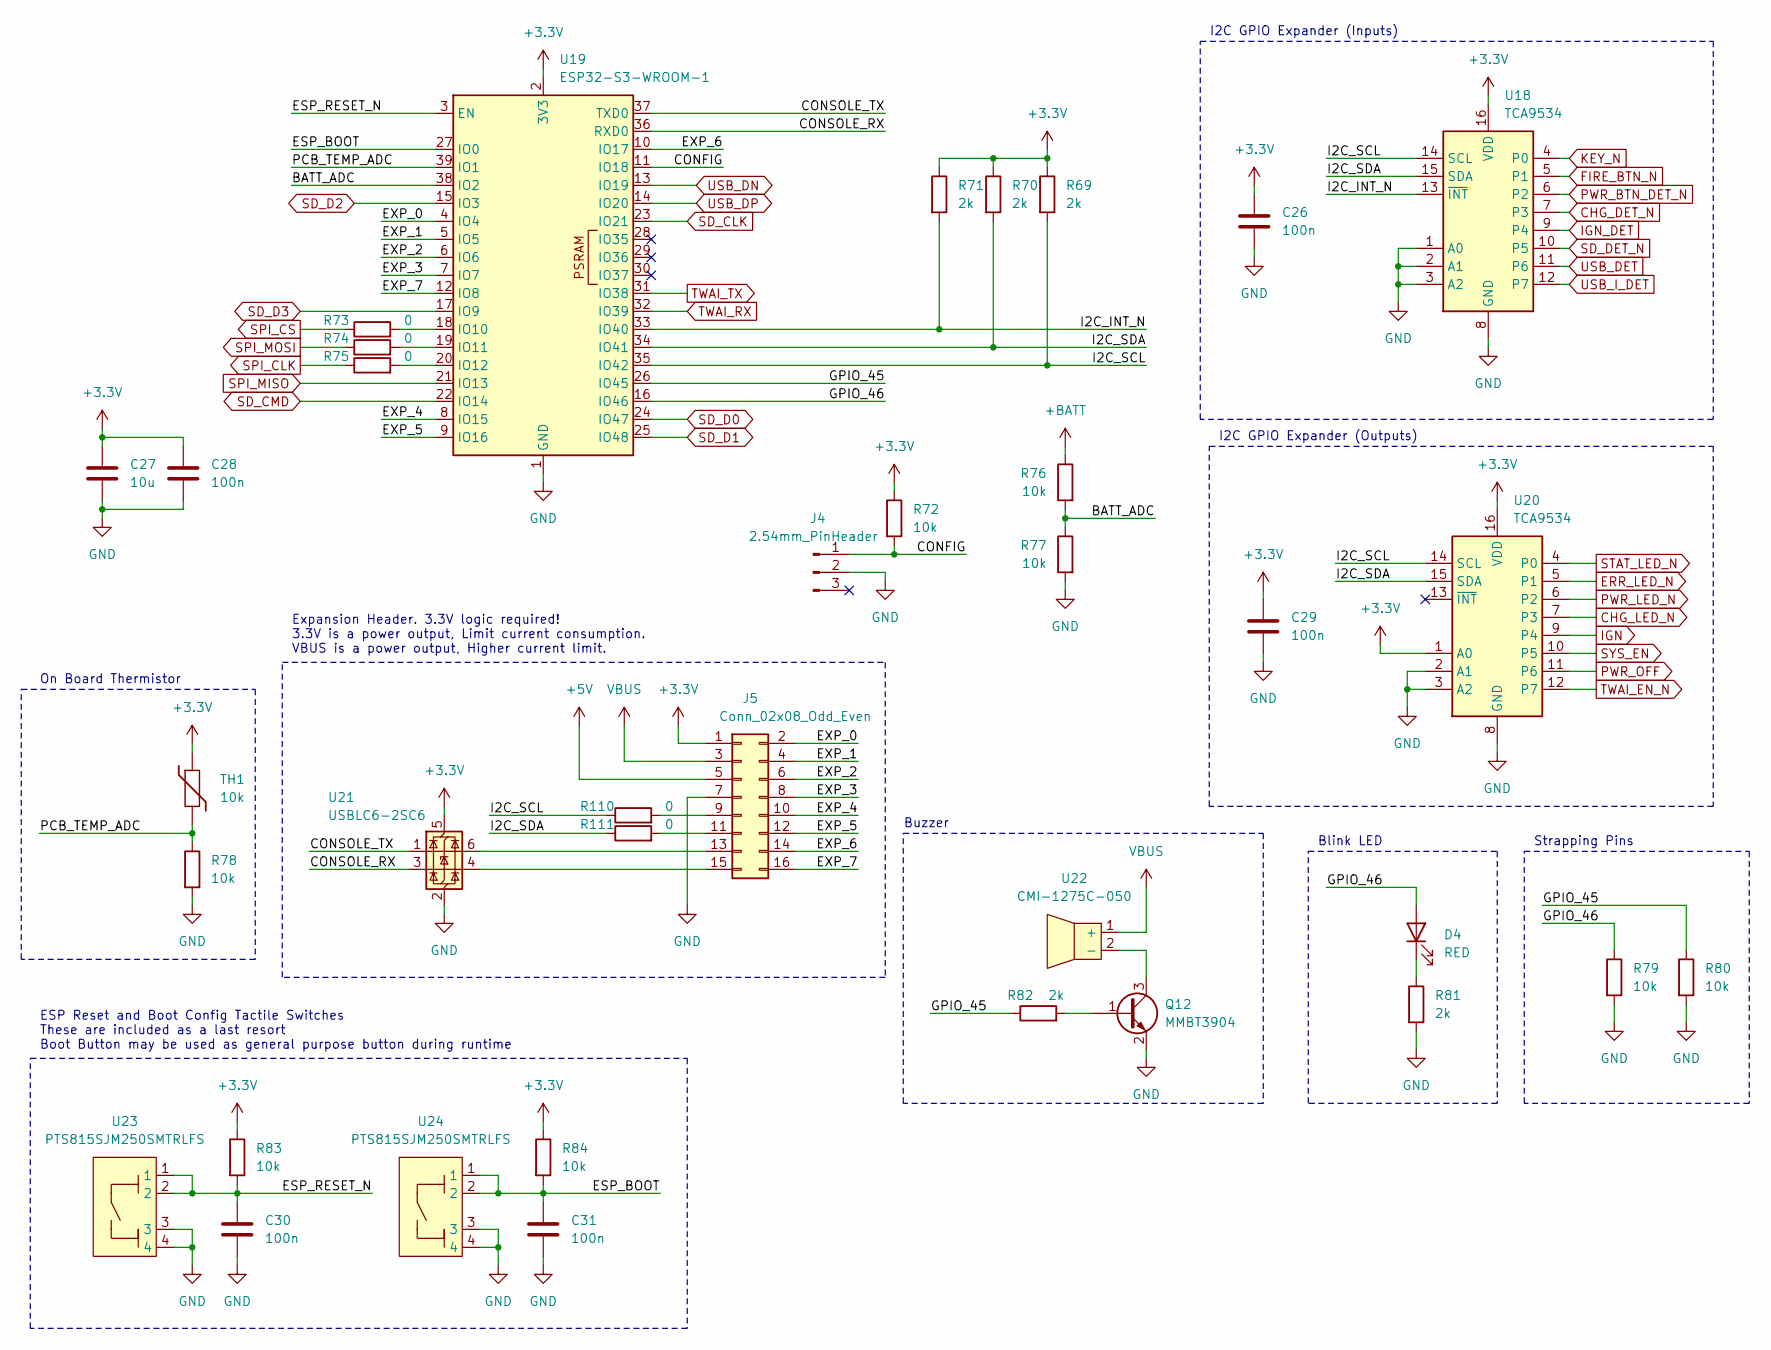
[picture p20: schematic Core.kicad_sch, Unify]

Parts:
C26, C28, C29, C30, C31: 100n; C_0603_1608Metric
C27: 10u; C_0603_1608Metric
D4: RED; LED_0603_1608Metric
J4: 2.54mm_PinHeader; PinHeader_1x03_P2.54mm_Vertical
J5: Conn_02x08_Odd_Even; PinHeader_2x08_P2.54mm_Vertical
Q12: MMBT3904; SOT-23
R69, R70, R71, R81, R82: 2k; R_0603_1608Metric
R72, R76, R77, R78, R79, R80, R83, R84: 10k; R_0603_1608Metric
R73, R74, R75, R110, R111: 0; R_0603_1608Metric
TH1: 10k; R_0603_1608Metric
U18, U20: TCA9534; TSSOP-16_4.4x5mm_P0.65mm
U19: ESP32-S3-WROOM-1; ESP32-S3-WROOM-1U
U21: USBLC6-2SC6; SOT-23-6
U22: CMI-1275C-050
U23, U24: PTS815SJM250SMTRLFS

Connections:
+5V: J5.5; also elsewhere on the board
+BATT: R76.1; also elsewhere on the board
/Core/BATT_ADC: R76.2, R77.1, U19.38 (IO2)
/Core/CONFIG: J4.1, R72.2, U19.11 (IO18)
/Core/CONSOLE_RX: U19.36 (RXD0), U21.3 (I/O2)
/Core/CONSOLE_TX: U19.37 (TXD0), U21.1 (I/O1)
/Core/ESP_BOOT: C31.1, R84.2, U19.27 (IO0), U24.1, U24.2
/Core/ESP_RESET_N: C30.1, R83.2, U19.3 (EN), U23.1, U23.2
/Core/EXP_0: J5.2, U19.4 (IO4)
/Core/EXP_1: J5.4, U19.5 (IO5)
/Core/EXP_2: J5.6, U19.6 (IO6)
/Core/EXP_3: J5.8, U19.7 (IO7)
/Core/EXP_4: J5.10, U19.8 (IO15)
/Core/EXP_5: J5.12, U19.9 (IO16)
/Core/EXP_6: J5.14, U19.10 (IO17)
/Core/EXP_7: J5.16, U19.12 (IO8)
/Core/GPIO_45: R80.1, R82.1, U19.26 (IO45)
/Core/GPIO_46: D4.2 (A), R79.1, U19.16 (IO46)
/Core/I2C_INT_N: R71.2, U18.13 (~INT), U19.33 (IO40)
/Core/I2C_SCL: R69.2, R110.1, U18.14 (SCL), U19.35 (IO42), U20.14 (SCL)
/Core/I2C_SDA: R70.2, R111.1, U18.15 (SDA), U19.34 (IO41), U20.15 (SDA)
/Core/PCB_TEMP_ADC: R78.1, TH1.2, U19.39 (IO1)
CHG_DET_N: U18.7 (P3); also elsewhere on the board
CHG_LED_N: U20.7 (P3); also elsewhere on the board
ERR_LED_N: U20.5 (P1); also elsewhere on the board
FIRE_BTN_N: U18.5 (P1); also elsewhere on the board
GND: C26.2, C27.2, C28.2, C29.2, C30.2, C31.2, J4.2, J5.7, Q12.2 (E), R77.2, R78.2, R79.2, R80.2, R81.2, U18.1 (A0), U18.2 (A1), U18.3 (A2), U18.8 (GND), U19.1 (GND), U19.40 (GND), U19.41 (GND), U20.2 (A1), U20.3 (A2), U20.8 (GND), U21.2 (GND), U23.3, U23.4, U24.3, U24.4; also elsewhere on the board
IGN: U20.9 (P4); also elsewhere on the board
IGN_DET: U18.9 (P4); also elsewhere on the board
KEY_N: U18.4 (P0); also elsewhere on the board
unnamed: D4.1 (K), R81.1
unnamed: J5.9, R110.2
unnamed: J5.11, R111.2
unnamed: J5.13, U21.6 (I/O1)
unnamed: J5.15, U21.4 (I/O2)
unnamed: Q12.1 (B), R82.2
unnamed: Q12.3 (C), U22.2 (-)
unnamed: R73.2, U19.18 (IO10)
unnamed: R74.2, U19.19 (IO11)
unnamed: R75.2, U19.20 (IO12)
PWR_BTN_DET_N: U18.6 (P2); also elsewhere on the board
PWR_LED_N: U20.6 (P2); also elsewhere on the board
PWR_OFF: U20.11 (P6); also elsewhere on the board
SD_CLK: U19.23 (IO21); also elsewhere on the board
SD_CMD: U19.22 (IO14); also elsewhere on the board
SD_D0: U19.24 (IO47); also elsewhere on the board
SD_D1: U19.25 (IO48); also elsewhere on the board
SD_D2: U19.15 (IO3); also elsewhere on the board
SD_D3: U19.17 (IO9); also elsewhere on the board
SD_DET_N: U18.10 (P5); also elsewhere on the board
SPI_MISO: U19.21 (IO13); also elsewhere on the board
SPI_MOSI: R74.1; also elsewhere on the board
STAT_LED_N: U20.4 (P0); also elsewhere on the board
TWAI_EN_N: U20.12 (P7); also elsewhere on the board
TWAI_RX: U19.32 (IO39); also elsewhere on the board
TWAI_TX: U19.31 (IO38); also elsewhere on the board
USB_DET: U18.11 (P6); also elsewhere on the board
USB_DN: U19.13 (IO19); also elsewhere on the board
USB_DP: U19.14 (IO20); also elsewhere on the board
USB_I_DET: U18.12 (P7); also elsewhere on the board

Notes on the sheet:
On Board Thermistor
Strapping Pins
Expansion Header. 3.3V logic required! 3.3V is a power output, Limit current consumption. VBUS is a power output, Higher current limit.
Buzzer
ESP Reset and Boot Config Tactile Switches These are included as a last resort Boot Button may be used as general purpose button during runtime
I2C GPIO Expander (Outputs)
I2C GPIO Expander (Inputs)
Blink LED

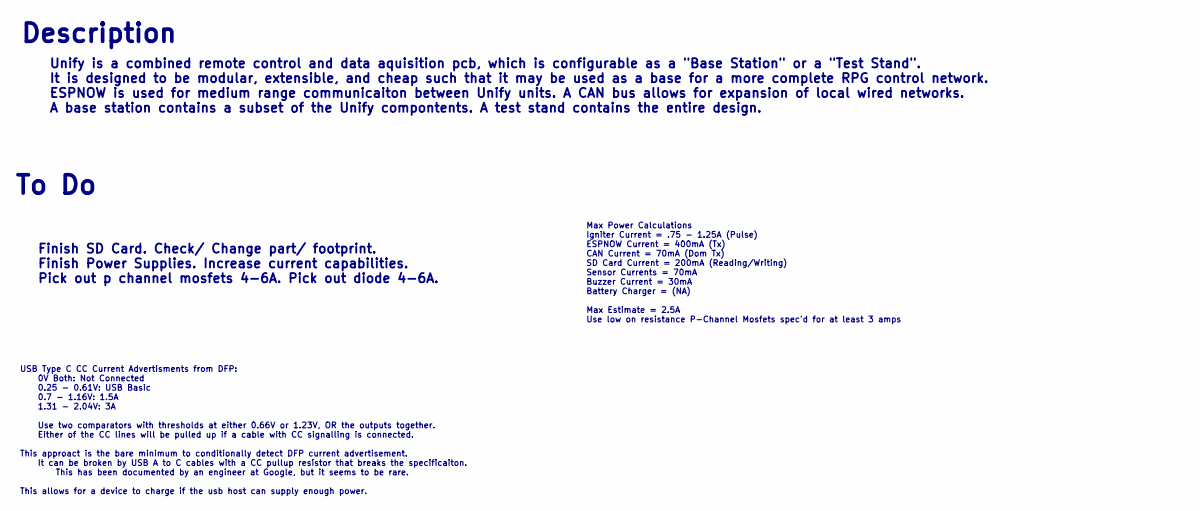
[picture p21: schematic Info.kicad_sch, Unify]

Notes on the sheet:
Max Power Calculations Igniter Current = .75 - 1.25A (Pulse) ESPNOW Current = 400mA (Tx) CAN Current = 70mA (Dom Tx) SD Card Current = 200mA (Reading/Writing) Sensor Currents = 70mA Buzzer Current = 30mA Battery Charger = (NA) Max Estimate = 2.5A Use low on resistance P-Channel Mosfets spec'd for a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
To Do
Finish SD Card. Check/ Change part/ footprint. Finish Power Supplies. Increase current capabilities. Pick out p channel mosfets 4-6A. Pick out diode 4-6A.
USB Type C CC Current Advertisments from DFP: 0V Both: Not Connected 0.25 - 0.61V: USB Basic 0.7 - 1.16V: 1.5A 1.31 - 2.04V: 3A Use two comparators with thresholds at either 0.66V or 1.23V, OR the outputs together. Either of the CC lines will be pulled up if a cable with CC signalling is connected.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
Unify is a combined remote control and data aquisition pcb, which is configurable as a "Base Station" or a "Test Stand". It is designed to be modular, extensible, and cheap such that it may be used as a base for a more complete RPG control network. ESPNOW is used for medium range communicaiton betw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
Description

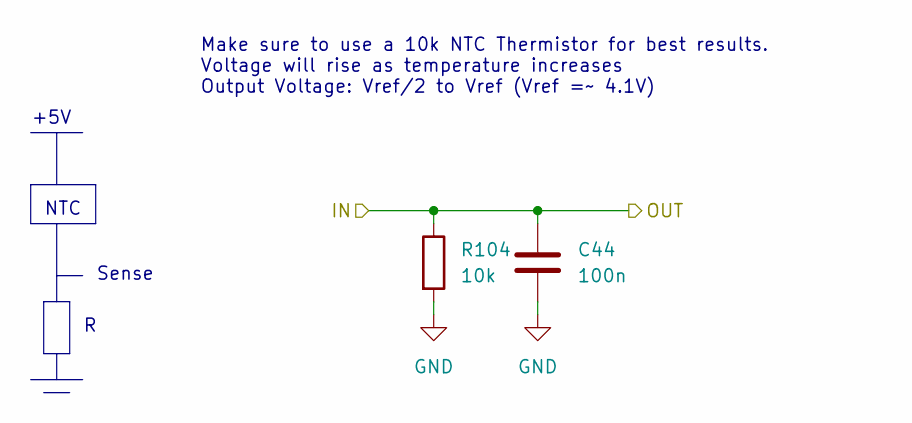
[picture p22: schematic Thermistor.kicad_sch, Unify]

Parts:
C44: 100n; C_0603_1608Metric
R104: 10k; R_0603_1608Metric

Connections:
GND: C44.2, R104.2; also elsewhere on the board
TH_2: C44.1, R104.1; also elsewhere on the board

Parts of its further copies:
C43, C45: 100n; C_0603_1608Metric
R103, R105: 10k; R_0603_1608Metric

Connections of its further copies:
GND: C43.2, C45.2, R103.2, R105.2; also elsewhere on the board
TH_1: C43.1, R103.1; also elsewhere on the board
TH_3: C45.1, R105.1; also elsewhere on the board

Notes on the sheet:
Make sure to use a 10k NTC Thermistor for best results. Voltage will rise as temperature increases Output Voltage: Vref/2 to Vref (Vref =~ 4.1V)
Sense
+5V
NTC
