unl-rpg/Unify/Hardware/Unify_1/Unify_1.kicad_pcb

## KiCad design Hardware/Unify_1/Unify_1.kicad_pcb (continued)

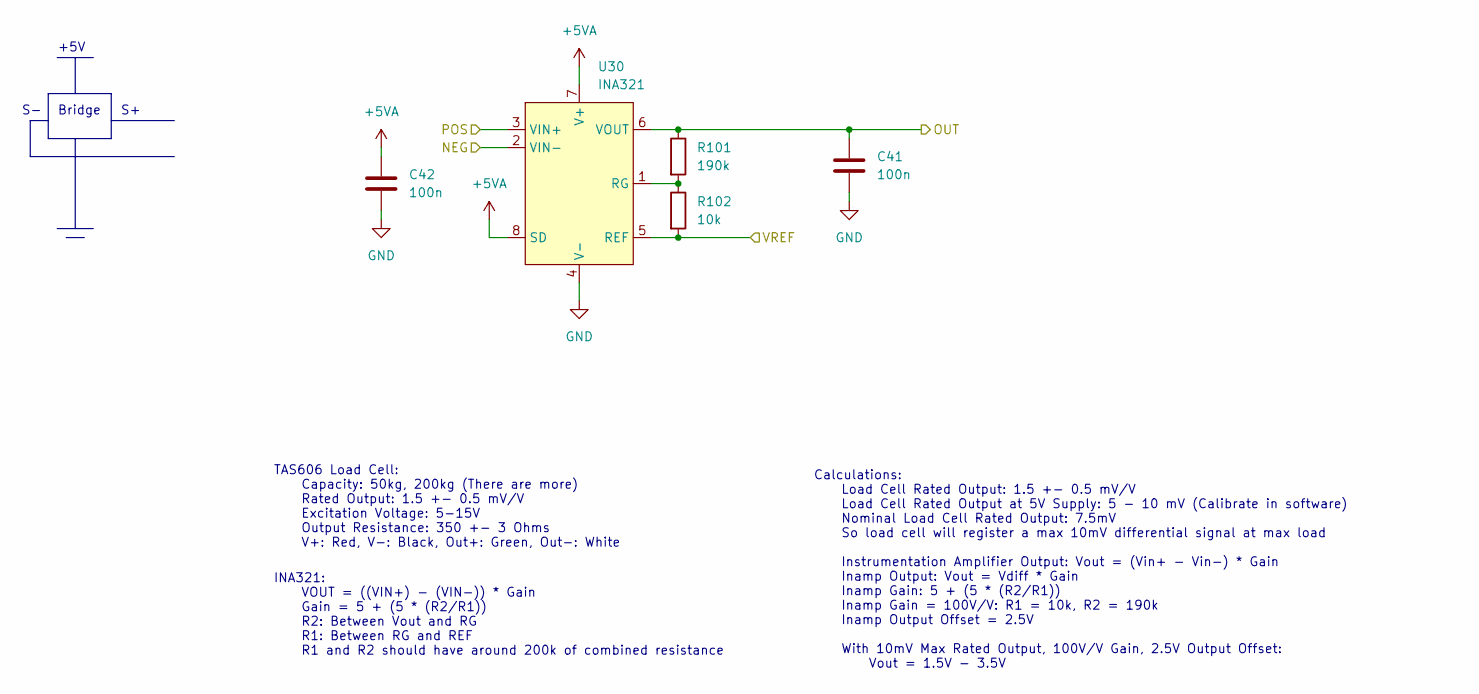
[picture p23: schematic LoadCell.kicad_sch, Unify]

Parts:
C41, C42: 100n; C_0603_1608Metric
R101: 190k; R_0603_1608Metric
R102: 10k; R_0603_1608Metric
U30: INA321

Connections:
+5VA: C42.1, U30.7 (V+), U30.8 (SD); also elsewhere on the board
/Peripherals/LC_3_ADC: C41.1, R101.1, U30.6 (VOUT); also elsewhere on the board
/Peripherals/VREF: R102.2, U30.5 (REF); also elsewhere on the board
GND: C41.2, C42.2, U30.4 (V-); also elsewhere on the board
LC_3_NEG: U30.2 (VIN-); also elsewhere on the board
LC_3_POS: U30.3 (VIN+); also elsewhere on the board
unnamed: R101.2, R102.1, U30.1 (RG)

Parts of its further copies:
C37, C38, C39, C40: 100n; C_0603_1608Metric
R97, R99: 190k; R_0603_1608Metric
R98, R100: 10k; R_0603_1608Metric
U28, U29: INA321

Connections of its further copies:
+5VA: C38.1, C40.1, U28.7 (V+), U28.8 (SD), U29.7 (V+), U29.8 (SD); also elsewhere on the board
/Peripherals/LC_1_ADC: C37.1, R97.1, U28.6 (VOUT); also elsewhere on the board
/Peripherals/LC_2_ADC: C39.1, R99.1, U29.6 (VOUT); also elsewhere on the board
/Peripherals/VREF: R98.2, R100.2, U28.5 (REF), U29.5 (REF); also elsewhere on the board
GND: C37.2, C38.2, C39.2, C40.2, U28.4 (V-), U29.4 (V-); also elsewhere on the board
LC_1_NEG: U28.2 (VIN-); also elsewhere on the board
LC_1_POS: U28.3 (VIN+); also elsewhere on the board
LC_2_NEG: U29.2 (VIN-); also elsewhere on the board
LC_2_POS: U29.3 (VIN+); also elsewhere on the board
unnamed: R97.2, R98.1, U28.1 (RG)
unnamed: R99.2, R100.1, U29.1 (RG)

Notes on the sheet:
Calculations: Load Cell Rated Output: 1.5 +- 0.5 mV/V Load Cell Rated Output at 5V Supply: 5 - 10 mV (Calibrate in software) Nominal Load Cell Rated Output: 7.5mV So load cell will register a max 10mV differential signal at max load Instrumentation Amplifier Output: Vout = (Vin+ - Vin-) * Gain Inam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
+5V
Bridge
TAS606 Load Cell: Capacity: 50kg, 200kg (There are more) Rated Output: 1.5 +- 0.5 mV/V Excitation Voltage: 5-15V Output Resistance: 350 +- 3 Ohms V+: Red, V-: Black, Out+: Green, Out-: White
INA321: VOUT = ((VIN+) - (VIN-)) * Gain Gain = 5 + (5 * (R2/R1)) R2: Between Vout and RG R1: Between RG and REF R1 and R2 should have around 200k of combined resistance

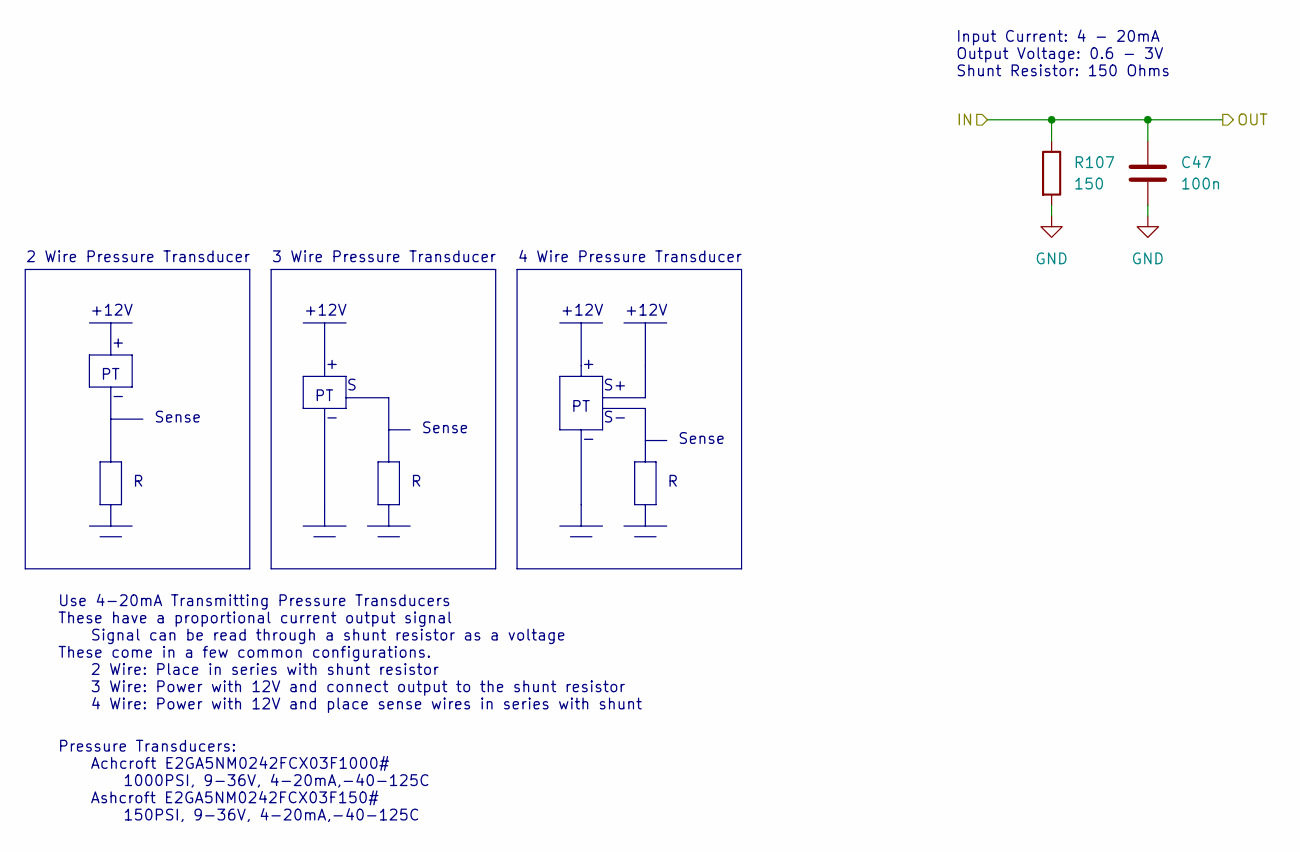
[picture p24: schematic PressureTransducer.kicad_sch, Unify]

Parts:
C47: 100n; C_0603_1608Metric
R107: 150; R_0603_1608Metric

Connections:
GND: C47.2, R107.2; also elsewhere on the board
PT_2: C47.1, R107.1; also elsewhere on the board

Parts of its further copies:
C46: 100n; C_0603_1608Metric
R106: 150; R_0603_1608Metric

Connections of its further copies:
GND: C46.2, R106.2; also elsewhere on the board
PT_1: C46.1, R106.1; also elsewhere on the board

Notes on the sheet:
2 Wire Pressure Transducer
4 Wire Pressure Transducer
+12V
Pressure Transducers: Achcroft E2GA5NM0242FCX03F1000# 1000PSI, 9-36V, 4-20mA,-40-125C Ashcroft E2GA5NM0242FCX03F150# 150PSI, 9-36V, 4-20mA,-40-125C
Sense
3 Wire Pressure Transducer
Use 4-20mA Transmitting Pressure Transducers These have a proportional current output signal Signal can be read through a shunt resistor as a voltage These come in a few common configurations. 2 Wire: Place in series with shunt resistor 3 Wire: Power with 12V and connect output to the shunt resisto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
Input Current: 4 - 20mA Output Voltage: 0.6 - 3V Shunt Resistor: 150 Ohms

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
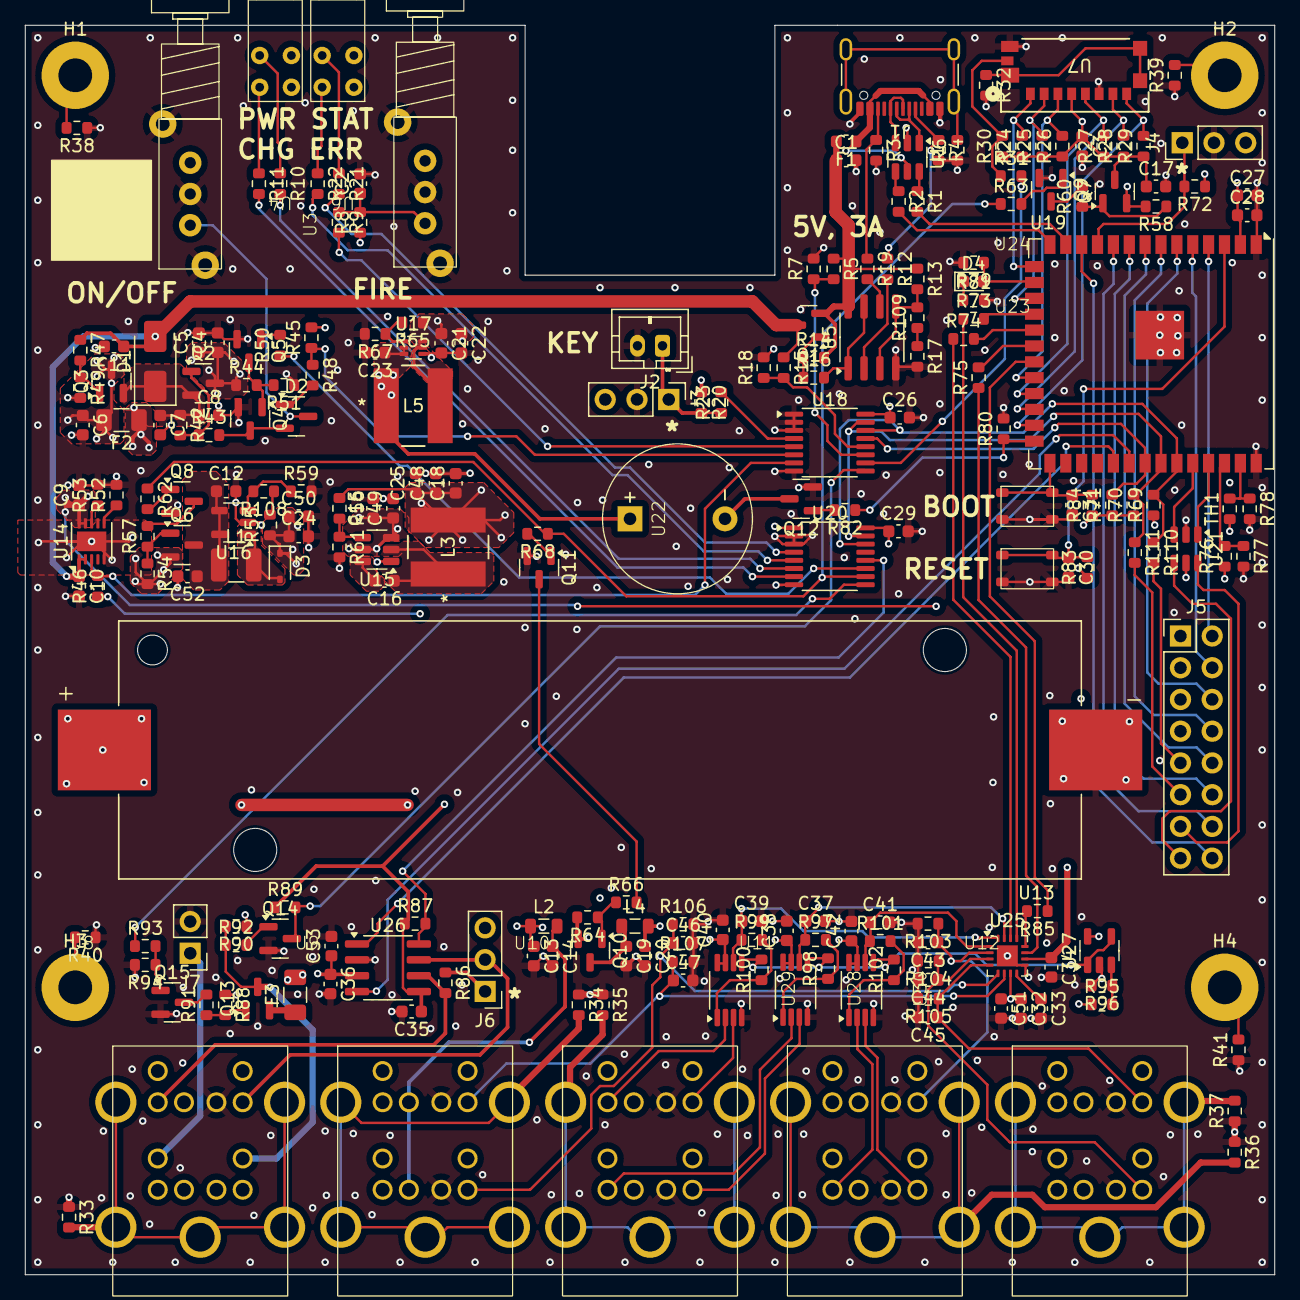
[picture p25: board Unify_1.kicad_pcb from above]

Board: 4 copper layers, 100.0 x 100.0 mm, 233 parts (0 on the bottom side), 163 nets.

Other parts of the board:
Q6: DMG2305UZ; SOT-23
Q8: MMBT3904; SOT-23
R54: 100k; R_0603_1608Metric
R57: 1k; R_0603_1608Metric

Their connections:
GND: Q8.2 (E); also elsewhere on the board
unnamed: Q6.1 (G), R54.1, R57.1
unnamed: Q8.3 (C), R57.2
